daveshah1/nova/README.md

nova
====

This is the primary git repository for Team Nova's CanSat project, containing base station software, rover software, electronics and CAD data.
