daveshah1/nova/electronics/landing module/Landing Module.png

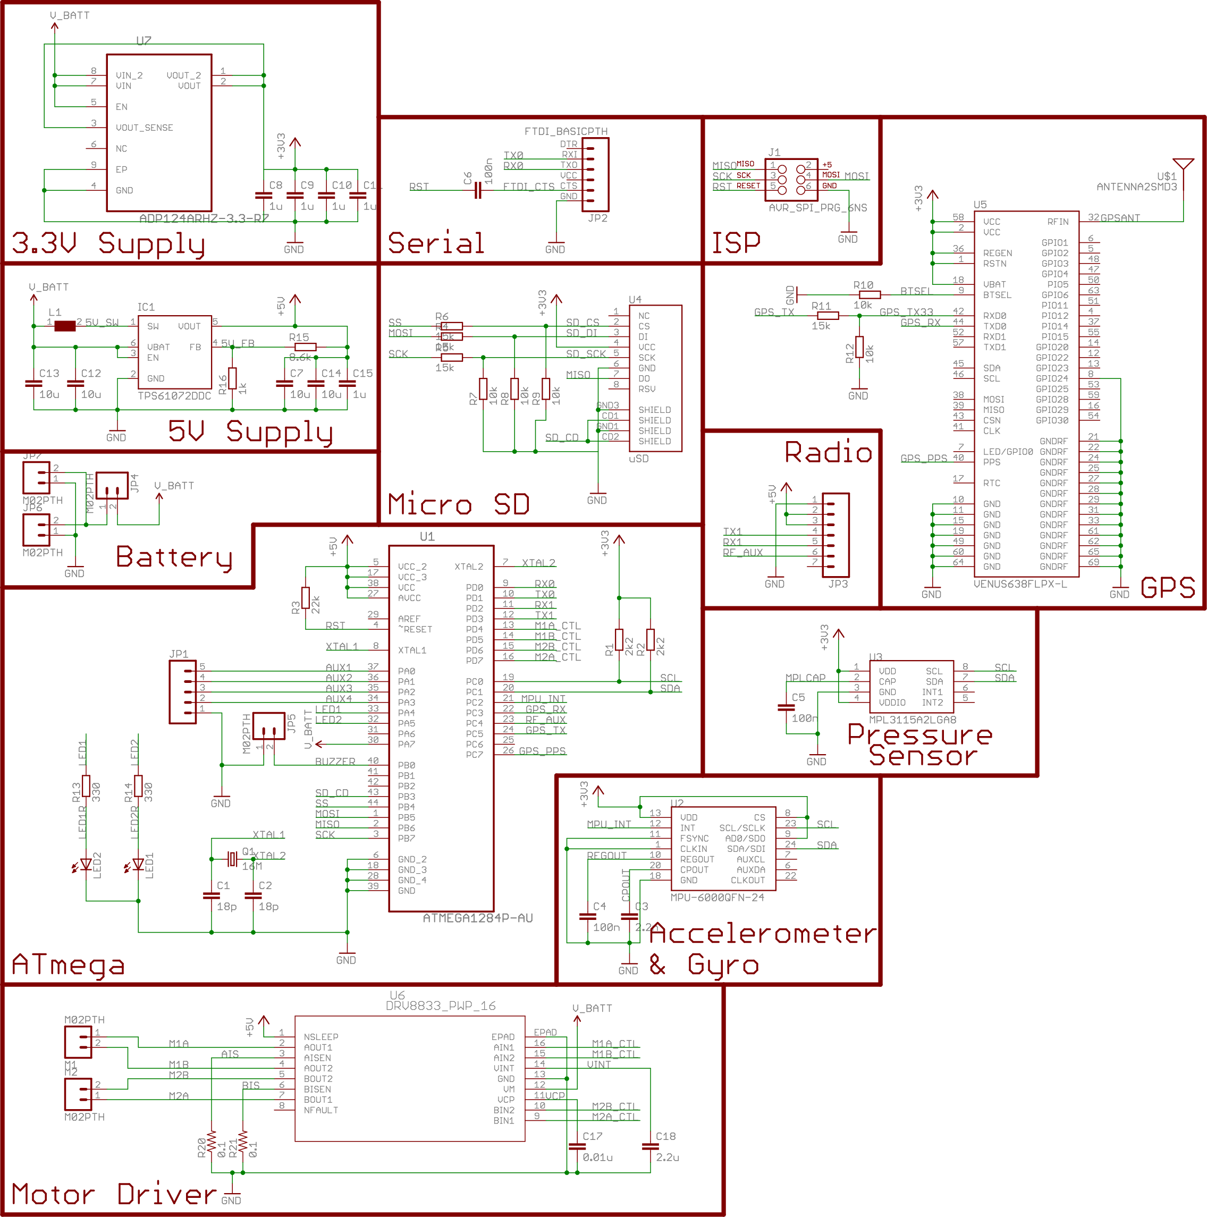
electronics/landing module/Landing Module.png
