daveshah1/nova/electronics/rover/CPU Board.png

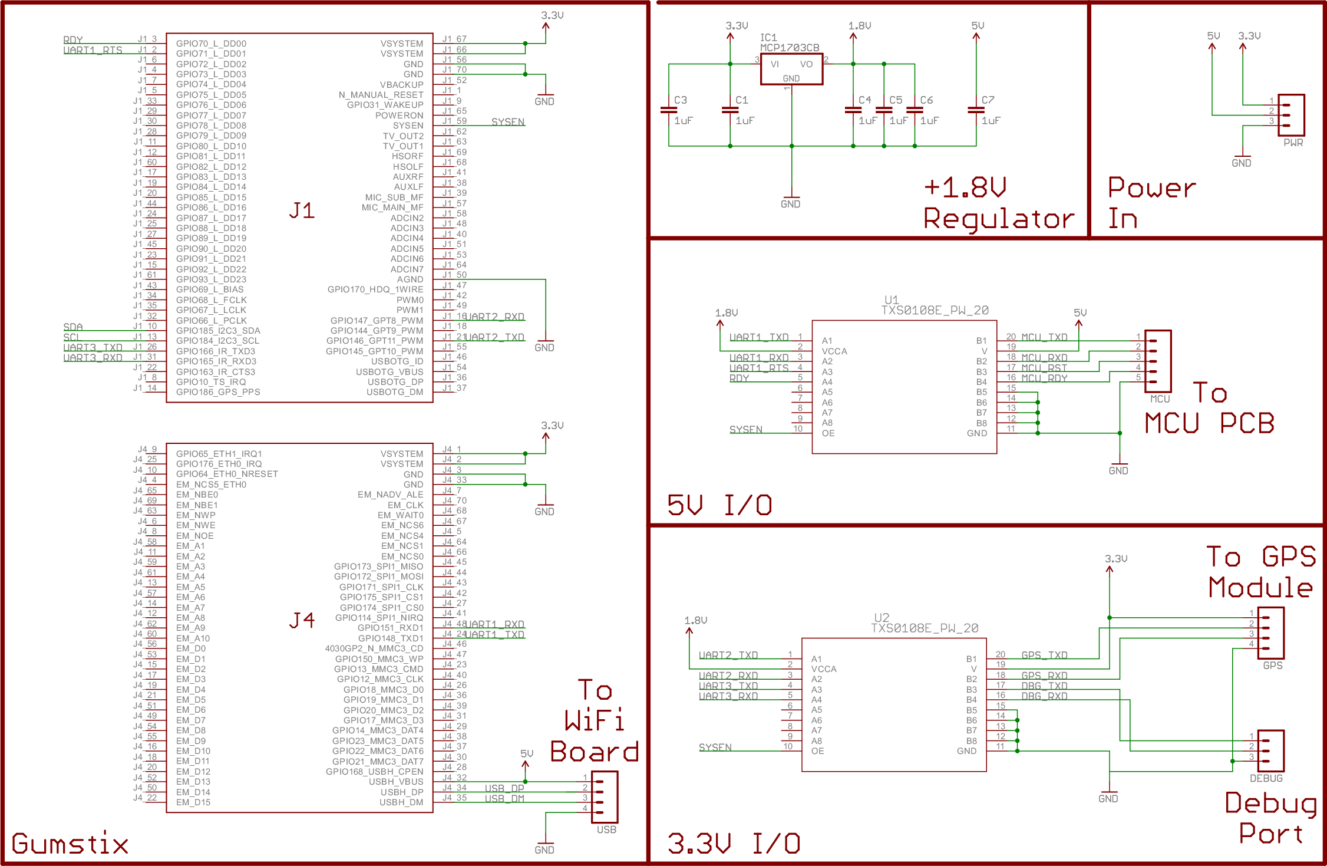
electronics/rover/CPU Board.png
