daveshah1/nova/electronics/rover/MCU Board.png

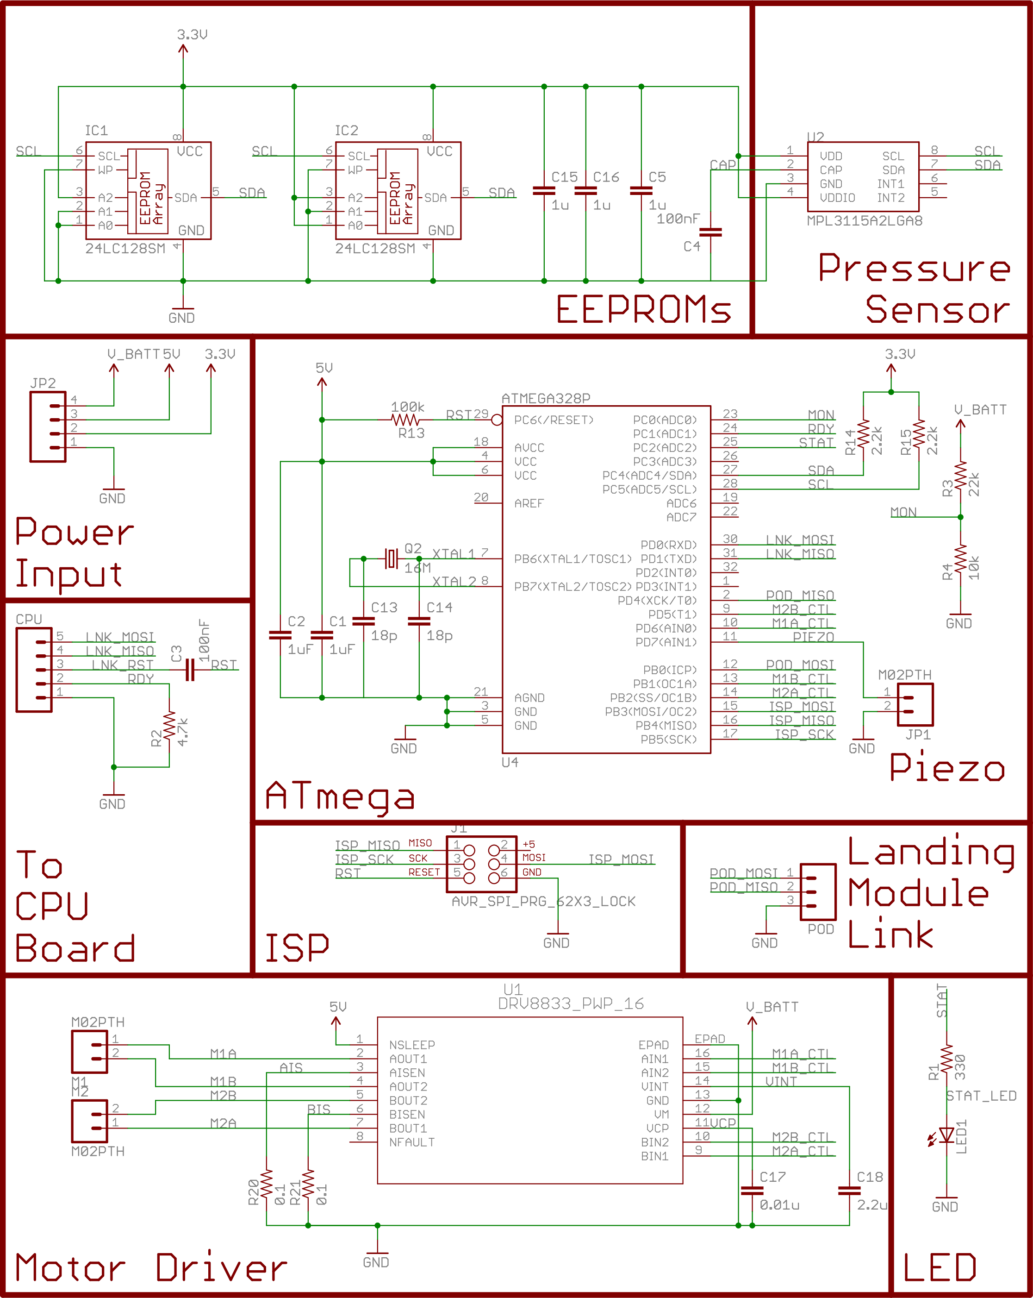
electronics/rover/MCU Board.png
