daveshah1/nova/electronics/rover/PMU Board.png

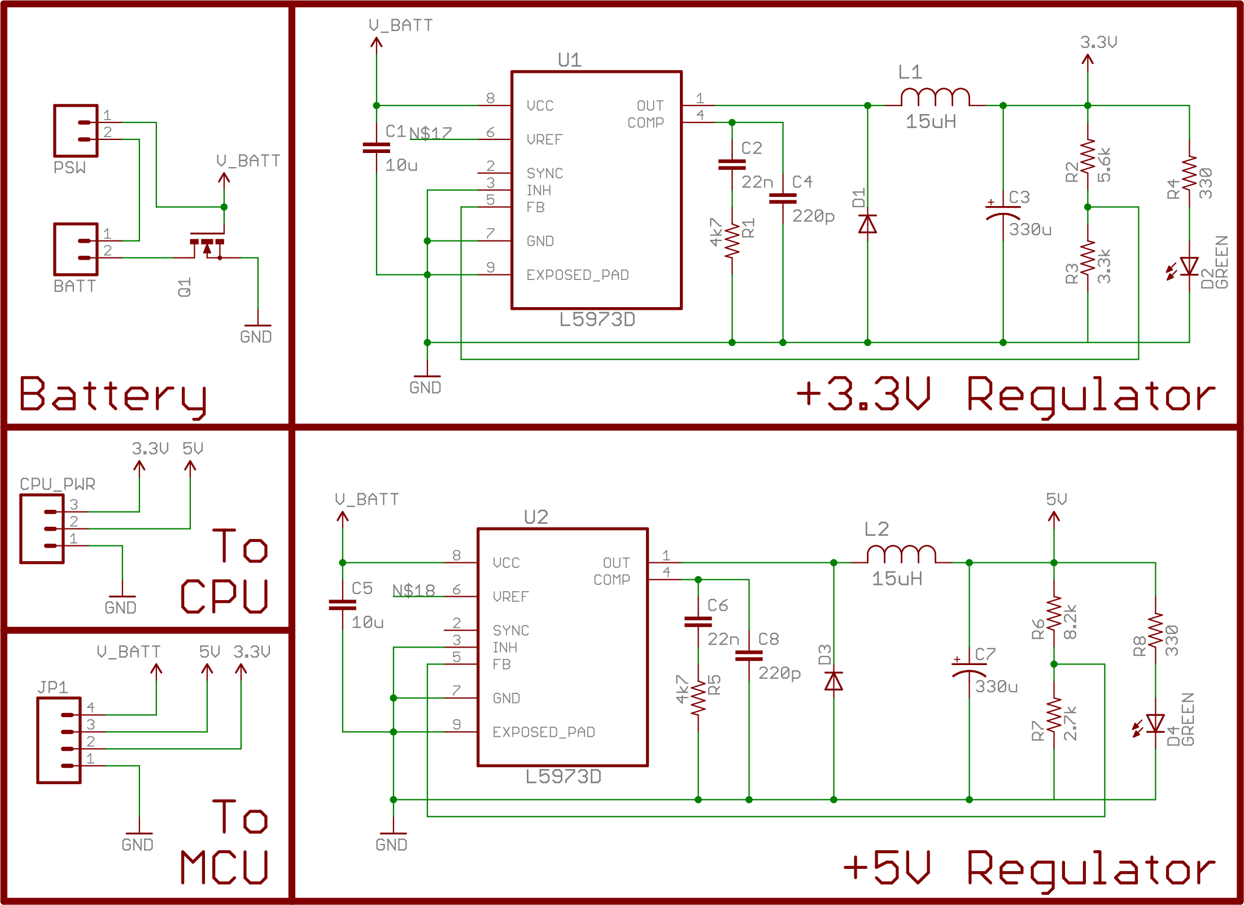
electronics/rover/PMU Board.png
