daveshah1/nova/houston/experimental/README

MAKE EACH OF THE FOLDERS HERE THE WORKSPACE FOLDER
TODO: Transfer all changes to master
