daveshah1/nova/electronics/landing module/Landing Module.pdf

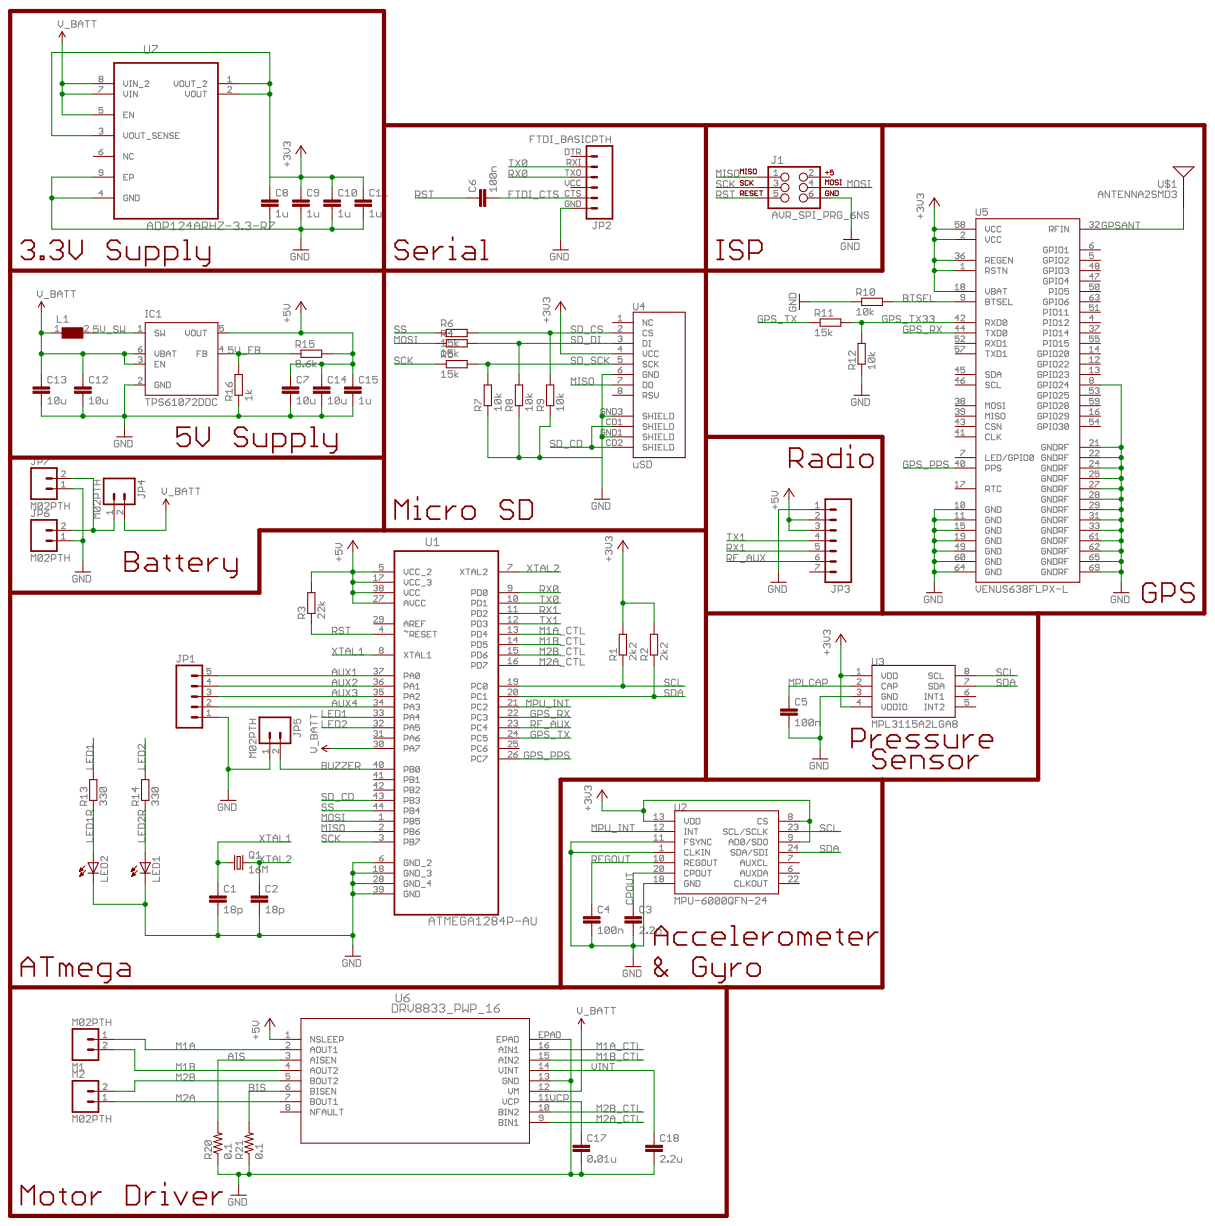
[picture p5: page 1]
