daveshah1/nova/electronics/rover/CPU Board.pdf

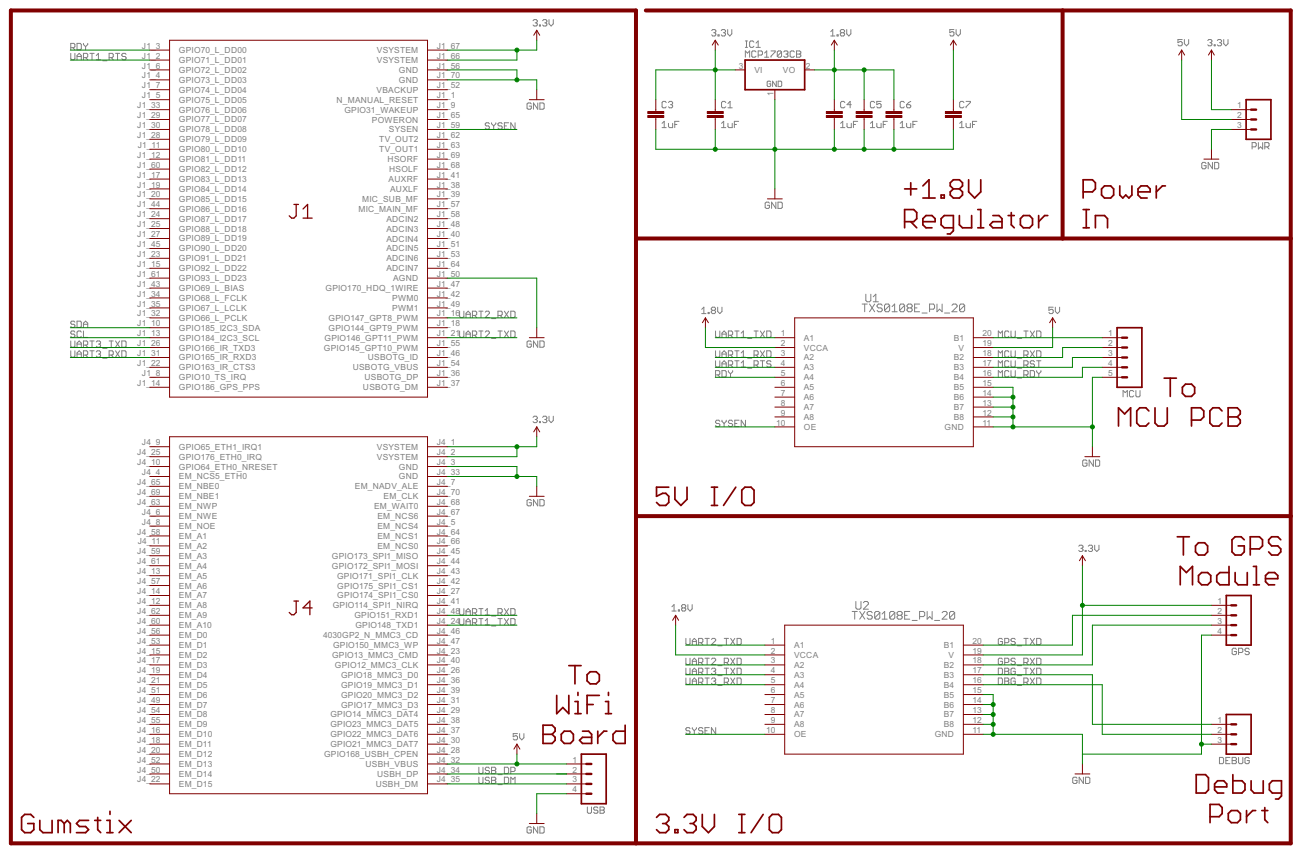
[picture p6: page 1]
