daveshah1/nova/electronics/rover/MCU Board.pdf

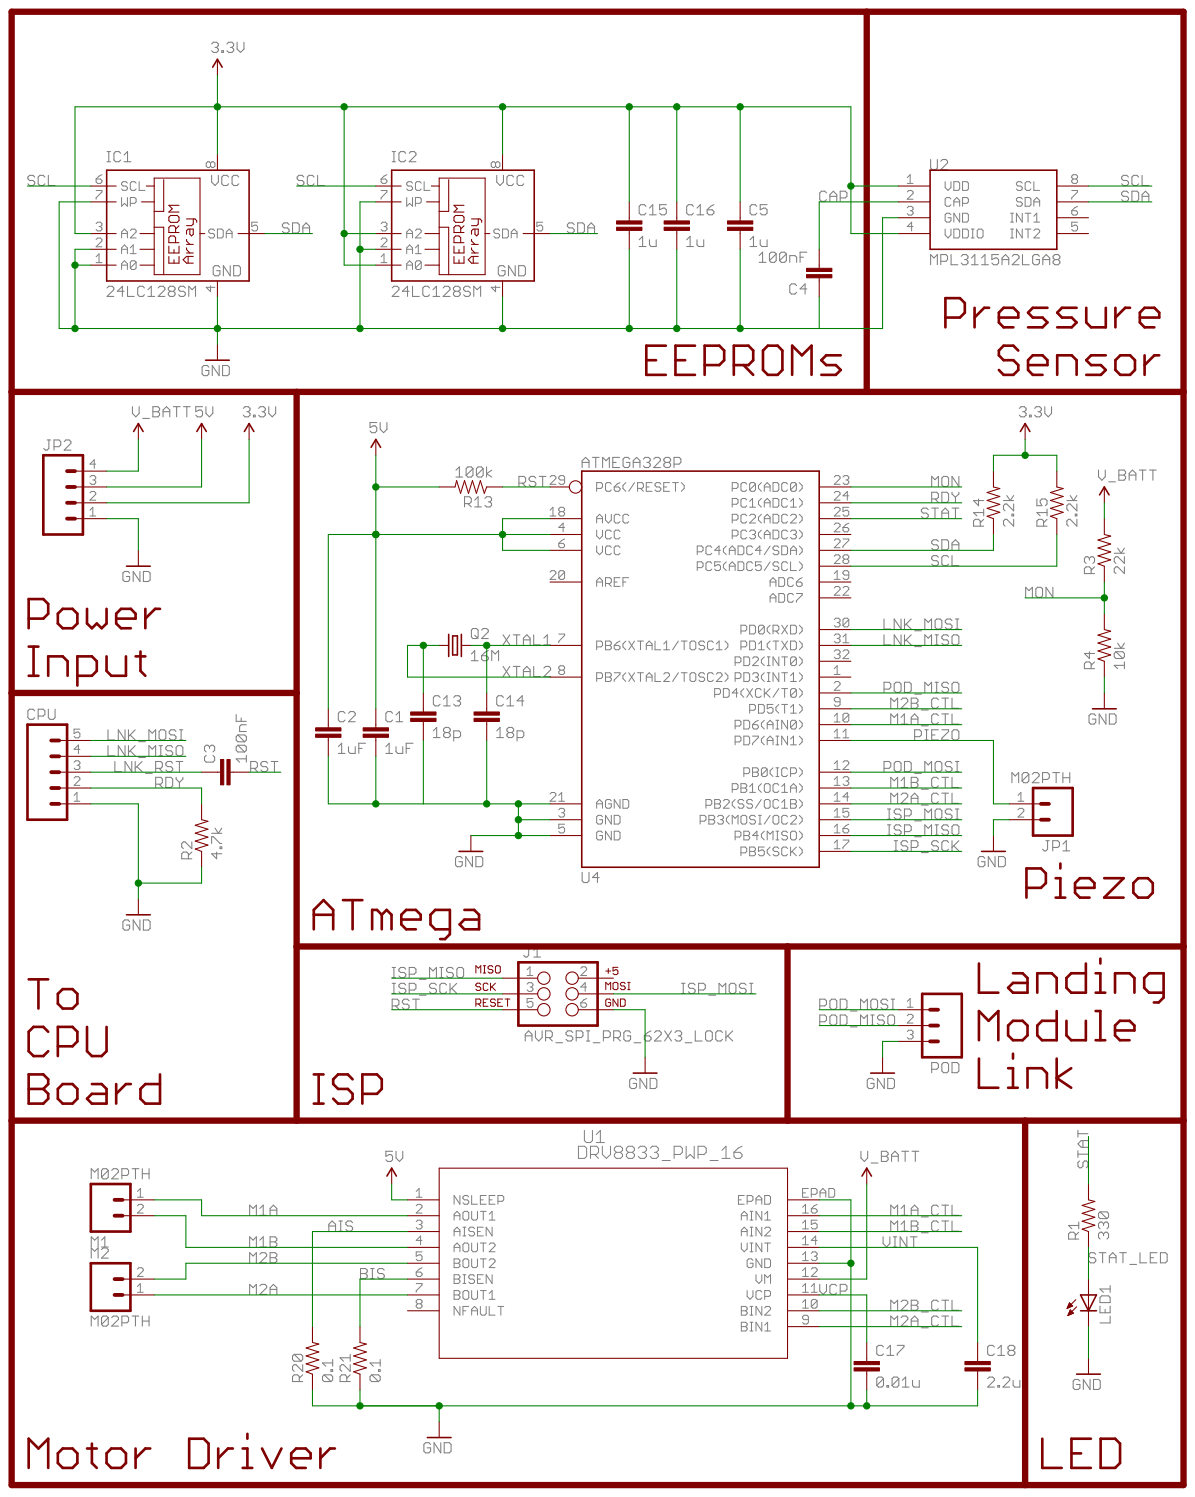
[picture p7: page 1]
