daveshah1/nova/electronics/rover/PMU Board.pdf

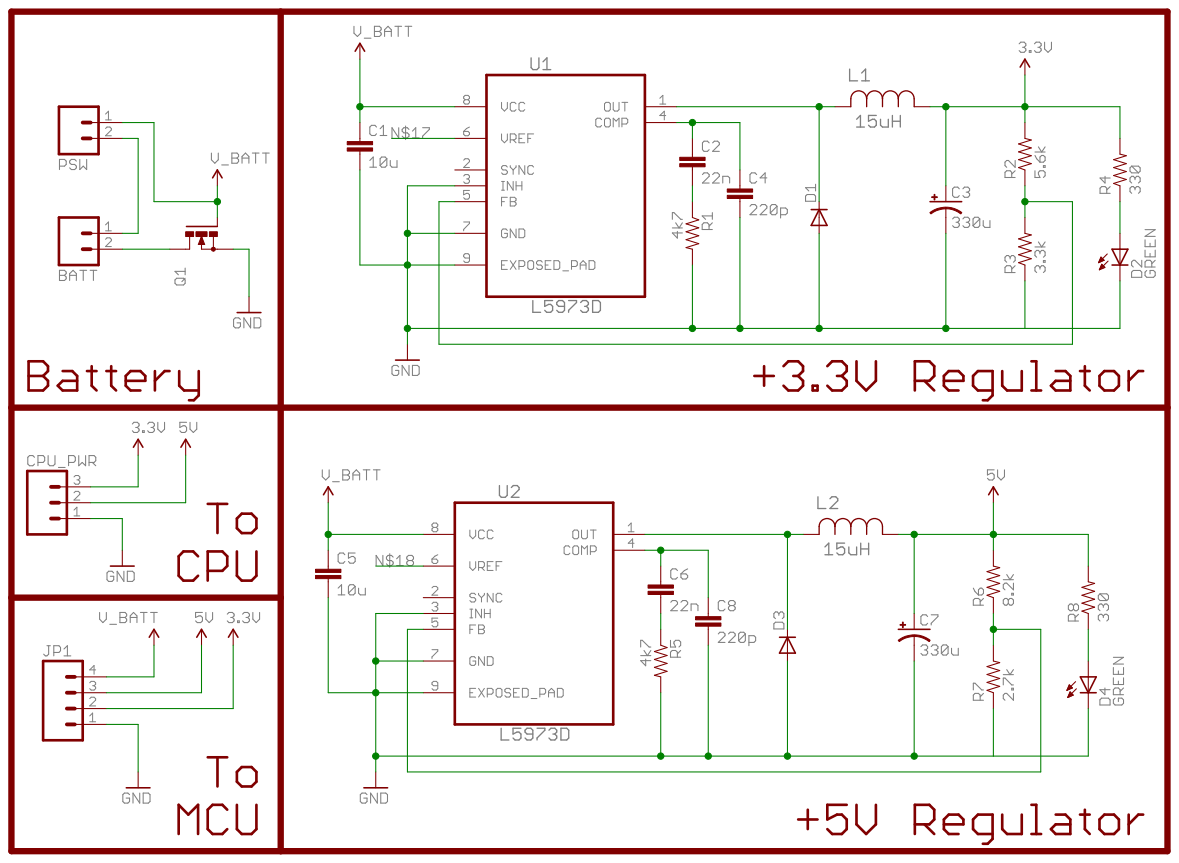
[picture p8: page 1]
