daveshah1/nova/electronics/rover/old (rev a)/MCU Board (Rev A).pdf

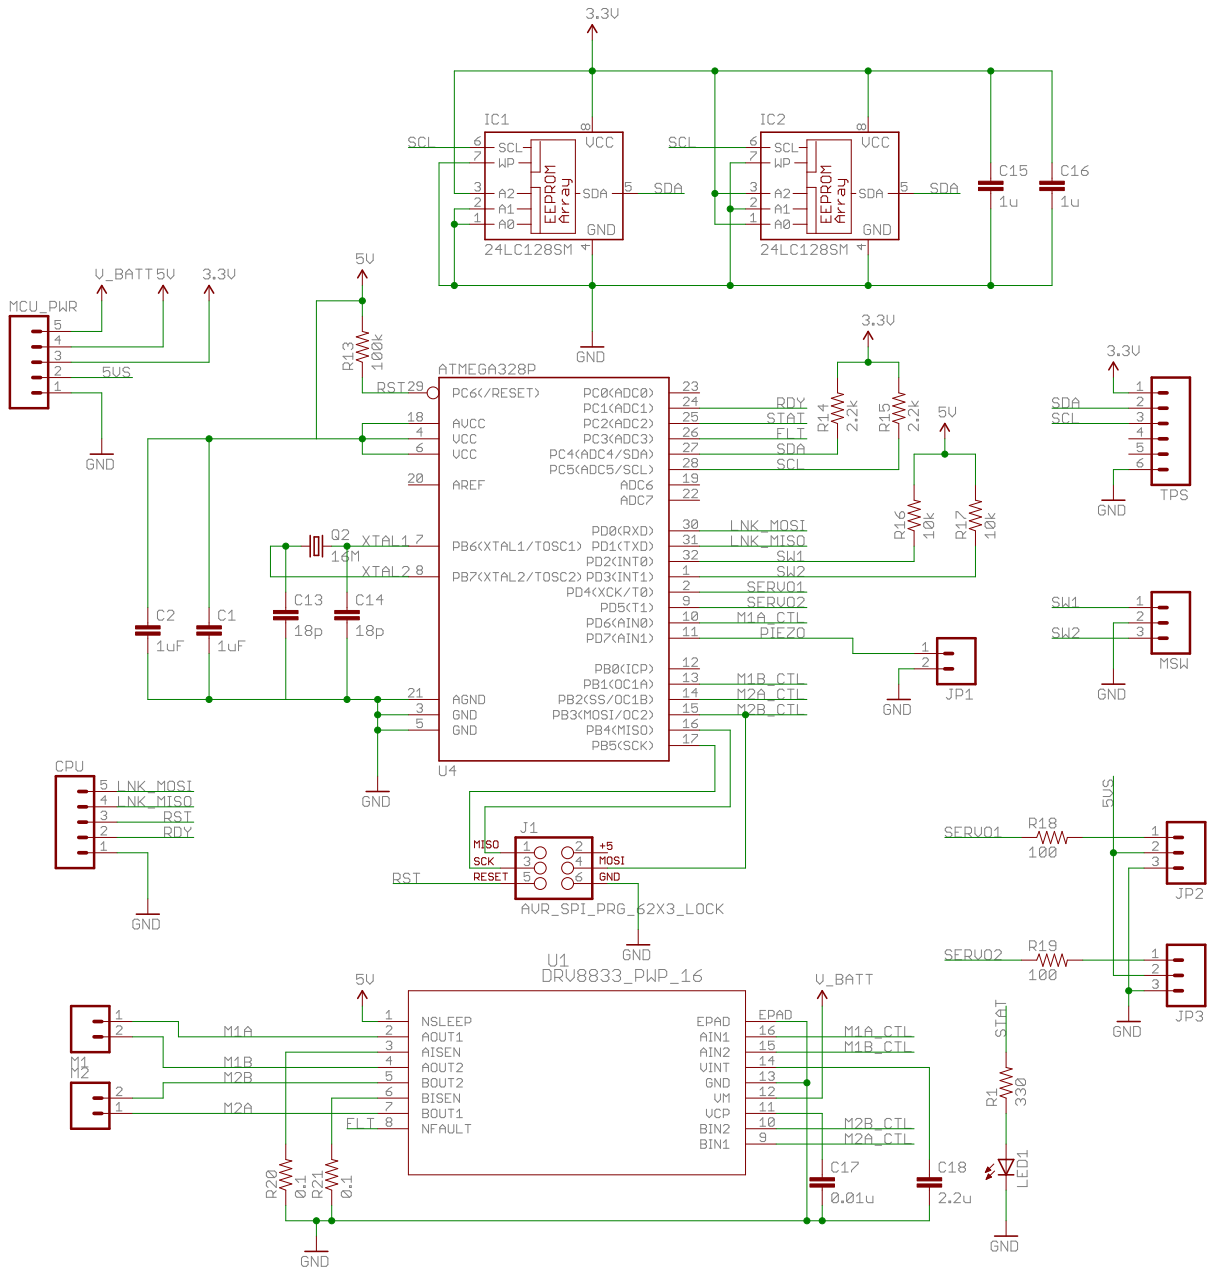
[picture p9: page 1]
