daveshah1/nova/electronics/rover/old (rev a)/PMU Board (Rev A).pdf

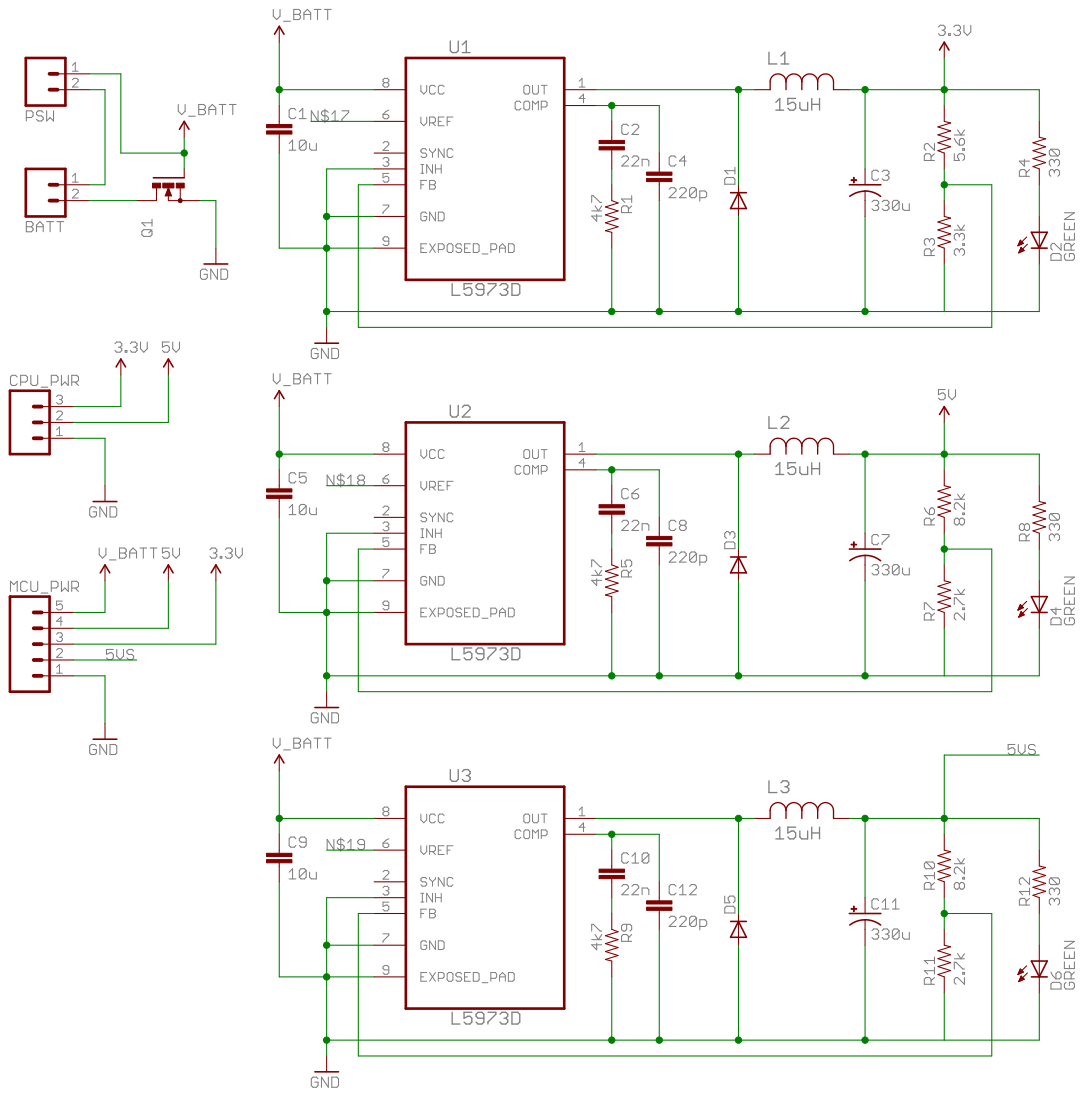
[picture p10: page 1]
