daveshah1/nova/electronics/rover/cpu.brd

## EAGLE design electronics/rover/cpu.brd (2013-09-23)

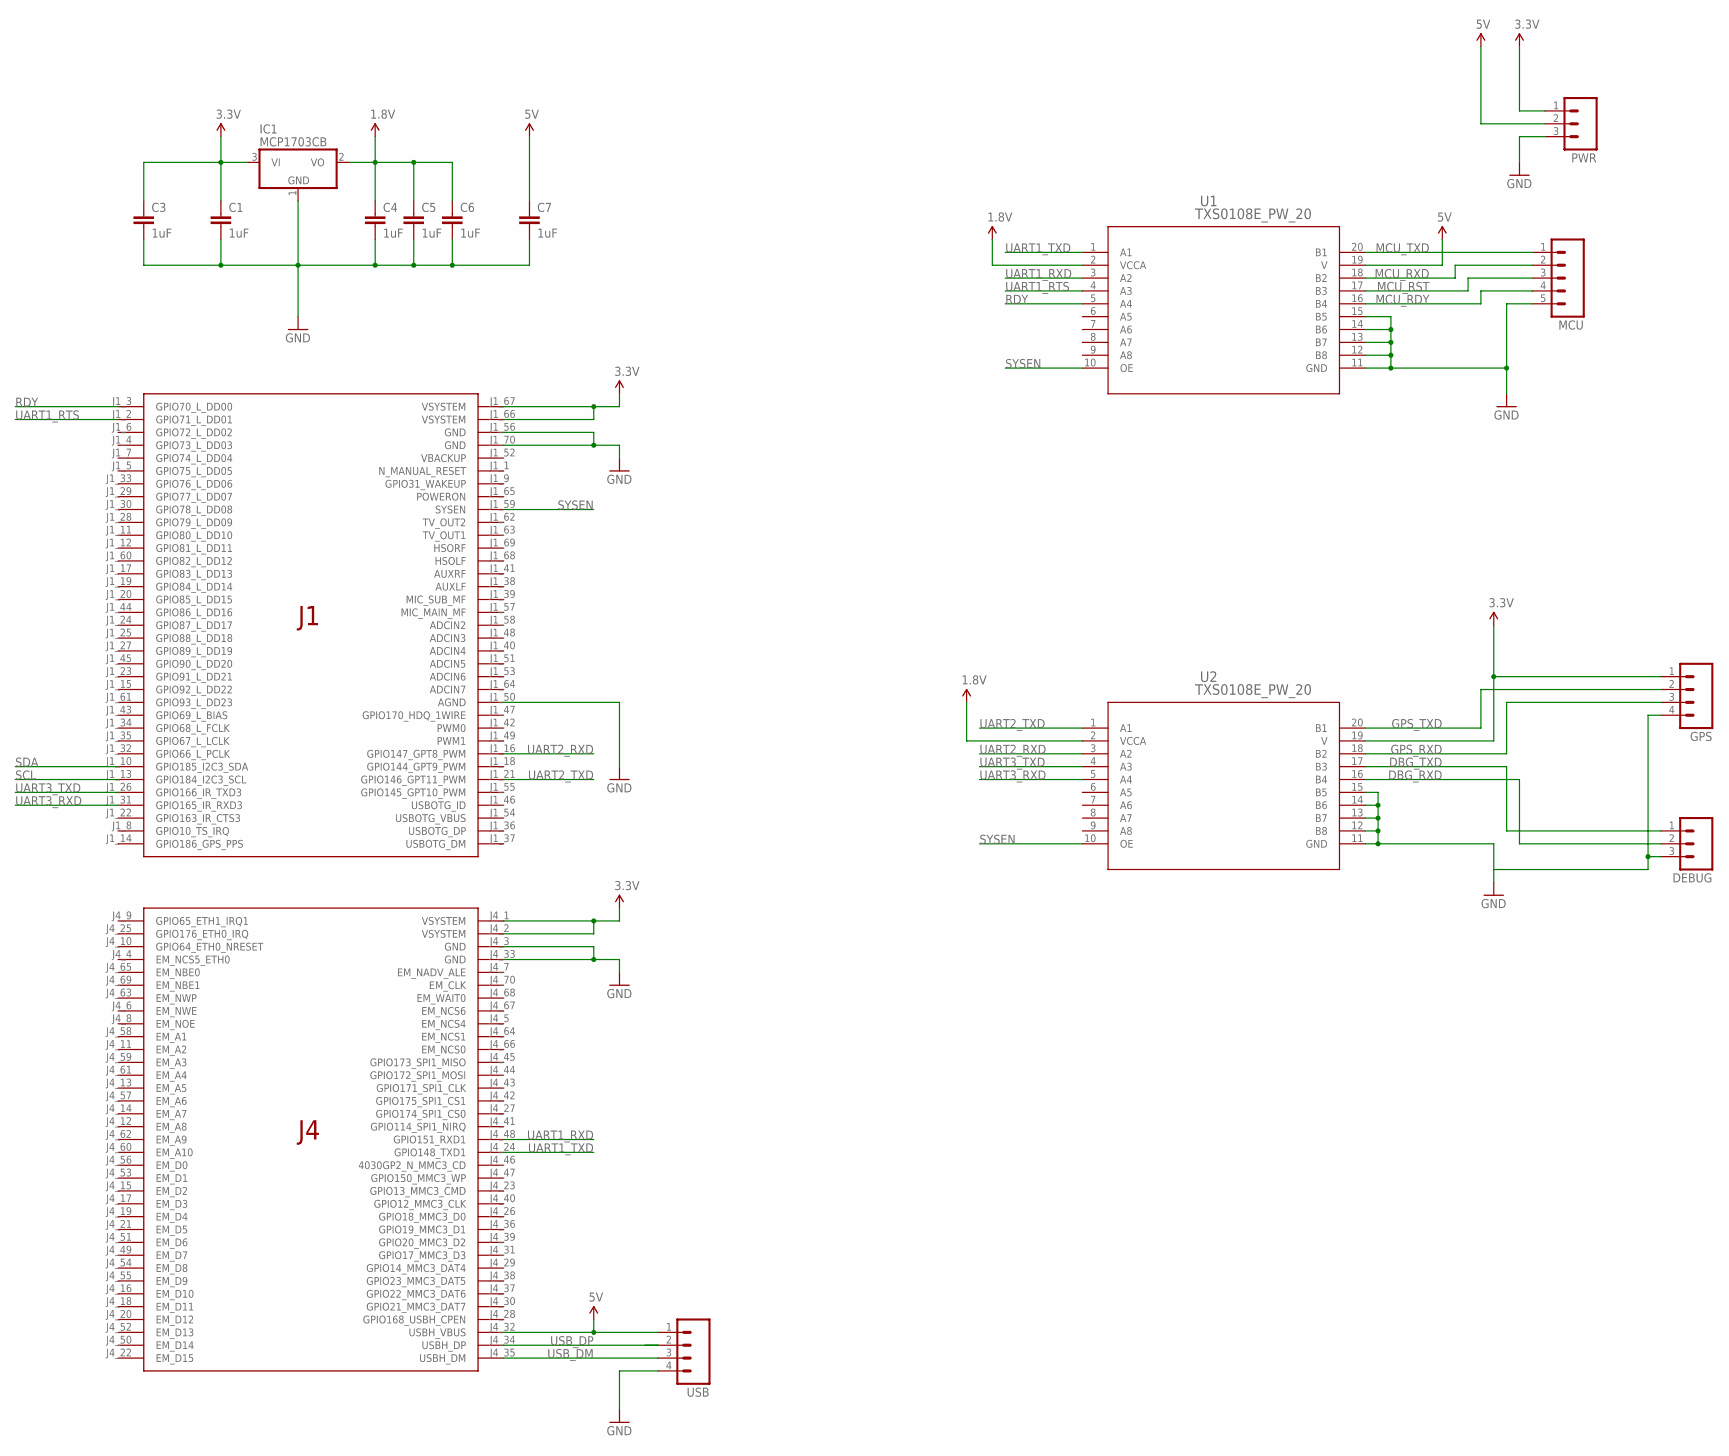
[picture p11: schematic cpu.sch]

Parts:
C1, C3, C4, C5, C6, C7: 1uF; 0805
DEBUG: M03LOCK_LONGPADS; 1X03_LOCK_LONGPADS
GPS: M04LONGPADS; 1X04_LONGPADS
IC1: MCP1703CB; SOT23
MCU: M05PTH_LONGPADS; 1X05_LONGPADS
PWR: M03LONGPADS; 1X03_LONGPADS
U1, U2: TXS0108E_PW_20; PW20
U$1: OVERO
USB: M04LONGPADS; 1X04_LONGPADS

Connections:
1.8V: C4.1, C5.1, C6.1, IC1.2 (VO), U1.2 (VCCA), U2.2 (VCCA)
3.3V: C1.1, C3.1, GPS.1, IC1.3 (VI), PWR.1, U2.19 (V), U$1.J1_66 (VSYSTEM), U$1.J1_67 (VSYSTEM), U$1.J4_1 (VSYSTEM), U$1.J4_2 (VSYSTEM)
5V: C7.1, PWR.2, U1.19 (V), U$1.J4_32 (USBH_VBUS), USB.1
DBG_RXD: DEBUG.2, U2.16 (B4)
DBG_TXD: DEBUG.1, U2.17 (B3)
GND: C1.2, C3.2, C4.2, C5.2, C6.2, C7.2, DEBUG.3, GPS.4, IC1.1 (GND), MCU.5, PWR.3, U1.11 (GND), U1.12 (B8), U1.13 (B7), U1.14 (B6), U1.15 (B5), U2.11 (GND), U2.12 (B8), U2.13 (B7), U2.14 (B6), U2.15 (B5), U$1.J1_50 (AGND), U$1.J1_56 (GND), U$1.J1_70 (GND), U$1.J4_3 (GND), U$1.J4_33 (GND), USB.4
GPS_RXD: GPS.3, U2.18 (B2)
GPS_TXD: GPS.2, U2.20 (B1)
MCU_RDY: MCU.4, U1.16 (B4)
MCU_RST: MCU.3, U1.17 (B3)
MCU_RXD: MCU.2, U1.18 (B2)
MCU_TXD: MCU.1, U1.20 (B1)
RDY: U1.5 (A4), U$1.J1_3 (GPIO70_L_DD00)
SCL: U$1.J1_13 (GPIO184_I2C3_SCL)
SDA: U$1.J1_10 (GPIO185_I2C3_SDA)
SYSEN: U1.10 (OE), U2.10 (OE), U$1.J1_59 (SYSEN)
UART1_RTS: U1.4 (A3), U$1.J1_2 (GPIO71_L_DD01)
UART1_RXD: U1.3 (A2), U$1.J4_48 (GPIO151_RXD1)
UART1_TXD: U1.1 (A1), U$1.J4_24 (GPIO148_TXD1)
UART2_RXD: U2.3 (A2), U$1.J1_16 (GPIO147_GPT8_PWM)
UART2_TXD: U2.1 (A1), U$1.J1_21 (GPIO146_GPT11_PWM)
UART3_RXD: U2.5 (A4), U$1.J1_31 (GPIO165_IR_RXD3)
UART3_TXD: U2.4 (A3), U$1.J1_26 (GPIO166_IR_TXD3)
USB_DM: U$1.J4_35 (USBH_DM), USB.3
USB_DP: U$1.J4_34 (USBH_DP), USB.2

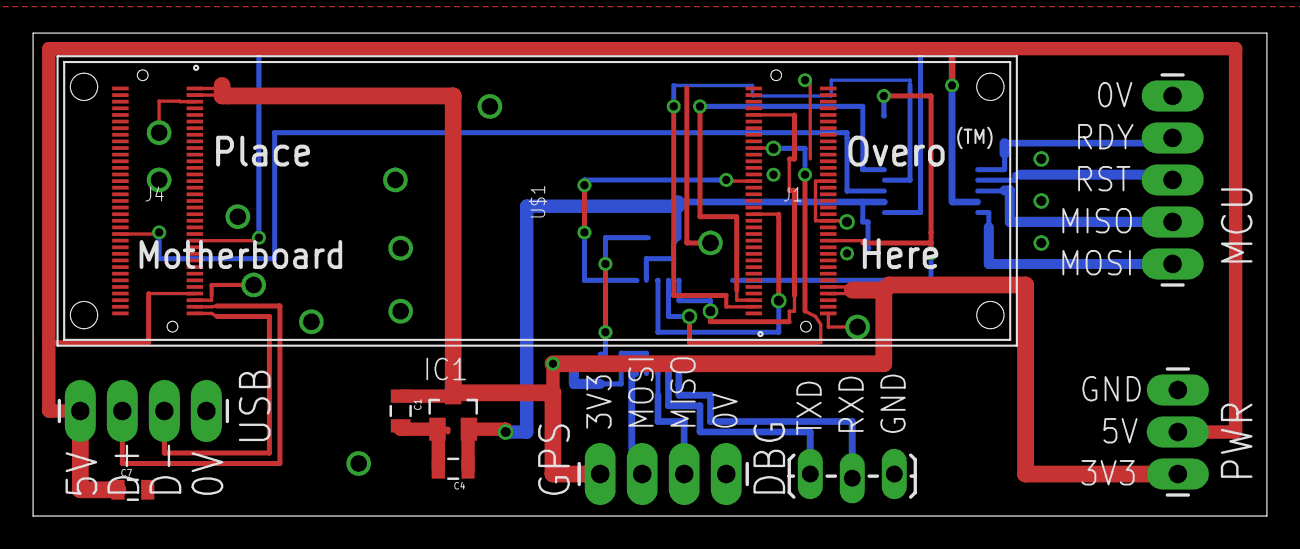
[picture p12: board cpu.brd from above]

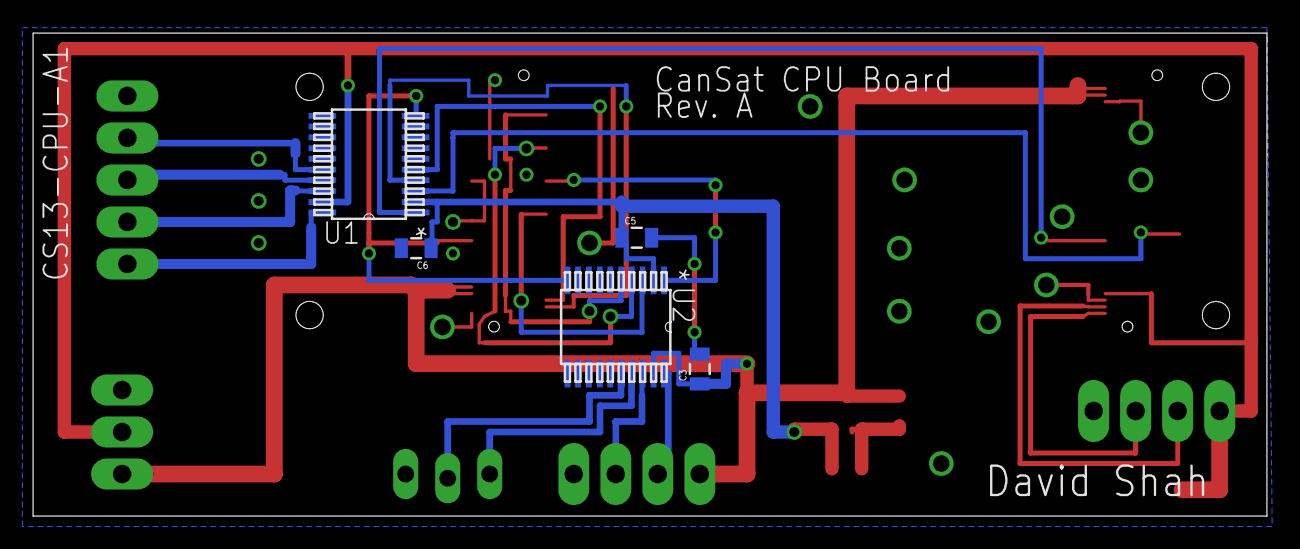
[picture p13: board cpu.brd from below]

Board: 2 copper layers, 74.6 x 29.2 mm, 15 parts (5 on the bottom side), 23 nets.
