daveshah1/nova/electronics/landing module/module.brd

## EAGLE design electronics/landing module/module.brd (2013-11-29)

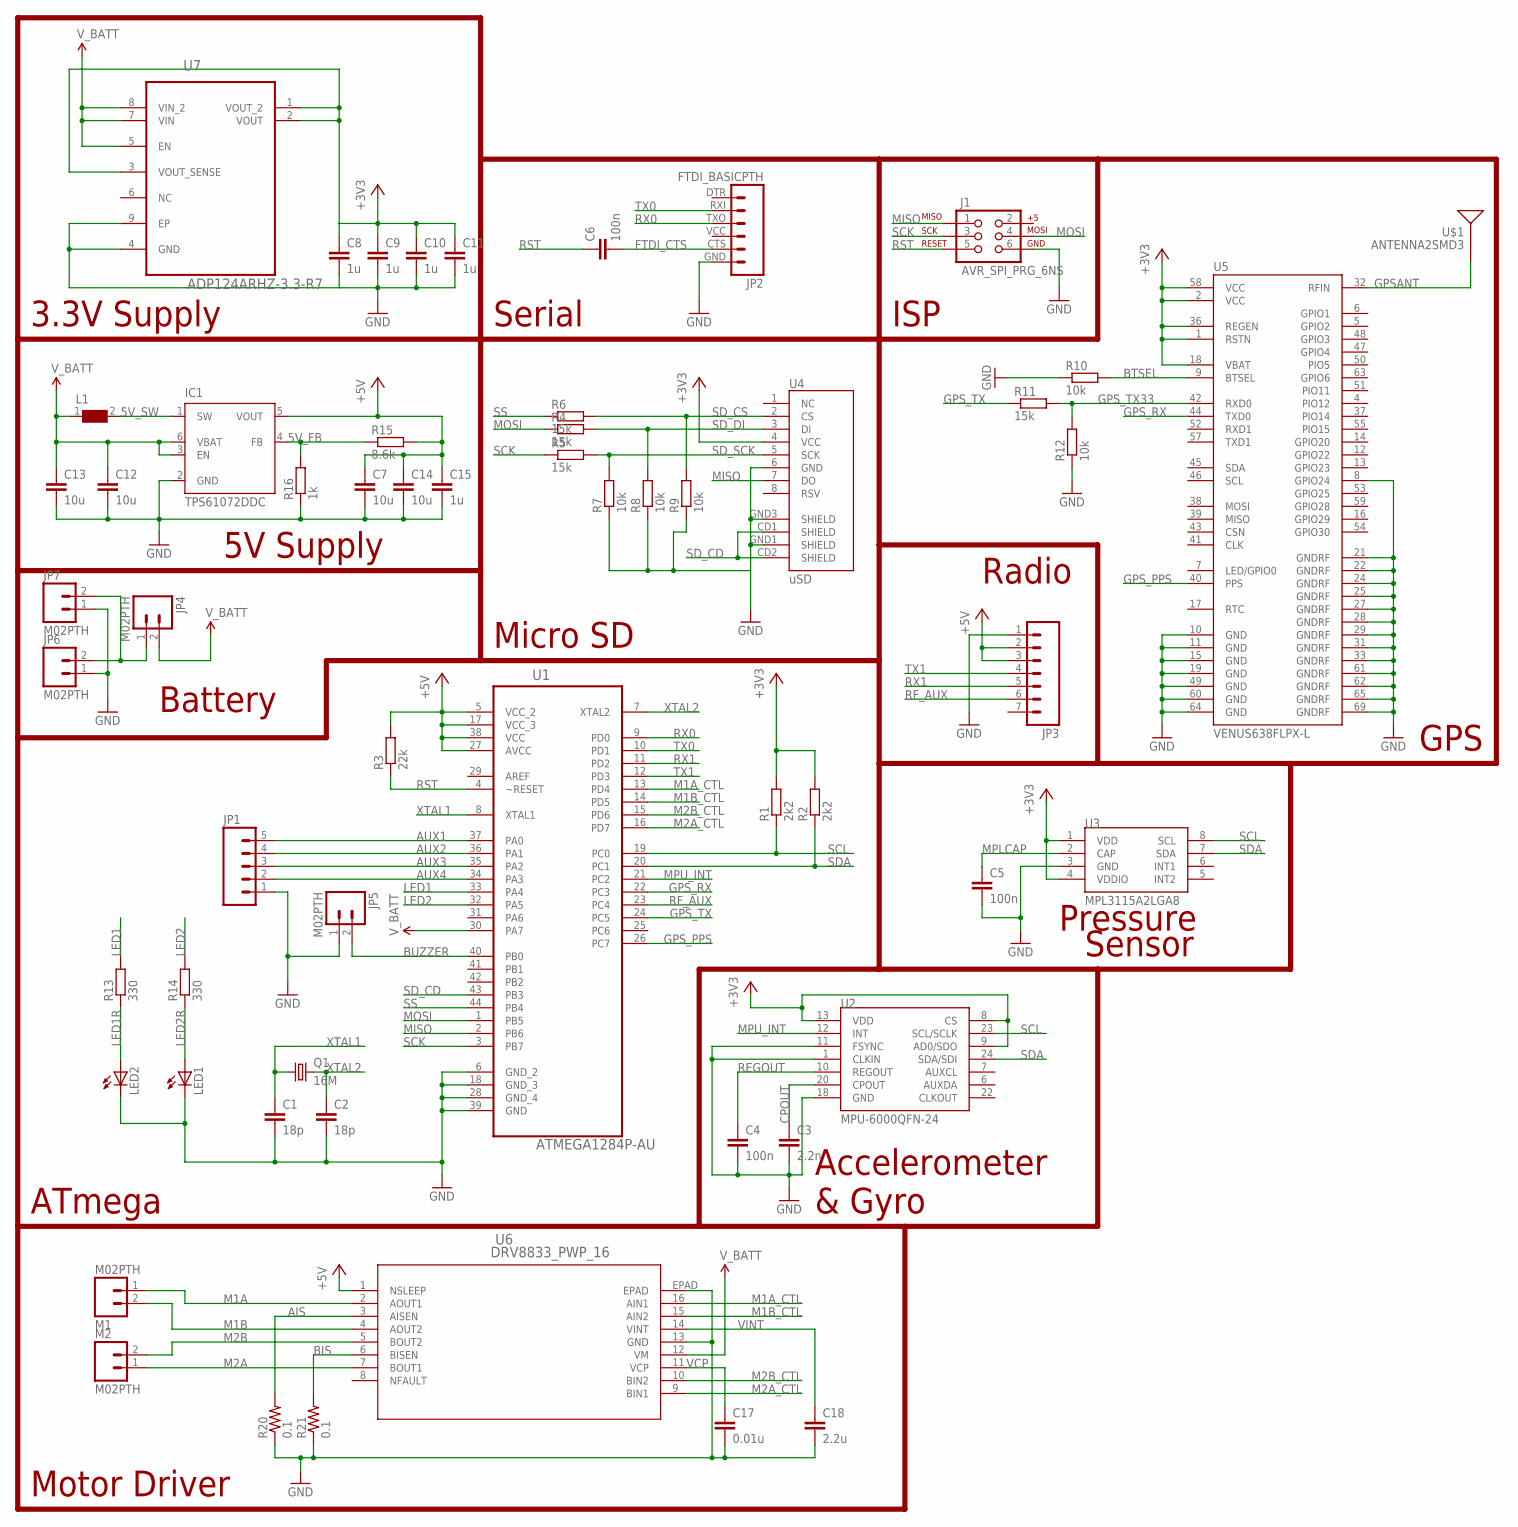
[picture p14: schematic module.sch]

Parts:
C1, C2: 18p; C0805
C3: 2.2n; C0805
C4, C5, C6: 100n; C0805
C7, C12, C13, C14: 10u; C0805
C8, C9, C10, C11: 1u; C0603
C15: 1u; C0805
C17: 0.01u; 0805
C18: 2.2u; 0805
IC1: TPS61072DDC; TSOT23-6_DDC
J1: AVR_SPI_PRG_6NS; 2X3-NS
JP1: M05PTH; 1X05
JP2: FTDI_BASICPTH; FTDI_BASIC
JP3: M07; 1X07
JP4, JP5, JP6, JP7: M02PTH; 1X02
L1: WE-TPC-744031004_3816; WE-TPC_3816
LED1, LED2: LEDCHIPLED_0805; CHIPLED_0805
M1, M2: M02PTH; 1X02
Q1: 16M; HC49UP
R1, R2: 2k2; R0805
R3: 22k; R0805
R4, R5, R6, R11: 15k; R0805
R7, R8, R9, R10, R12: 10k; R0805
R13, R14: 330; R0805
R15: 8.6k; R0805
R16: 1k; R0805
R20, R21: 0.1; 1206
U1: ATMEGA1284P-AU; QFP80P1200X1200X120-44N
U2: MPU-6000QFN-24; QFN-24-TESTING
U3: MPL3115A2LGA8; LGA8
U4: uSD; MICRO-SD-SOCKET-PP
U5: VENUS638FLPX-L; VENUS638FLPX
U6: DRV8833_PWP_16; PWP16_2P31X2P46
U7: ADP124ARHZ-3.3-R7; SOP65P490X110-9N
U$1: ANTENNA2SMD3; ANTENNA-CHIP4

Connections:
5V_FB: IC1.4 (FB), R15.1, R16.2
5V_SW: IC1.1 (SW), L1.2
+3V3: C8.1, C9.1, C10.1, C11.1, R1.2, R2.2, U2.8 (CS), U2.9 (AD0/SDO), U2.13 (VDD), U3.1 (VDD), U3.4 (VDDIO), U4.4 (VCC), U5.1 (RSTN), U5.2 (VCC), U5.18 (VBAT), U5.36 (REGEN), U5.58 (VCC), U7.1 (VOUT_2), U7.2 (VOUT), U7.3 (VOUT_SENSE)
+5V: C7.1, C14.1, C15.1, IC1.5 (VOUT), JP3.2, JP3.3, R3.2, R15.2, U1.5 (VCC_2), U1.17 (VCC_3), U1.27 (AVCC), U1.38 (VCC), U6.1 (NSLEEP)
AIS: R20.2, U6.3 (AISEN)
AUX1: JP1.5, U1.37 (PA0)
AUX2: JP1.4, U1.36 (PA1)
AUX3: JP1.3, U1.35 (PA2)
AUX4: JP1.2, U1.34 (PA3)
BIS: R21.2, U6.6 (BISEN)
BTSEL: R10.2, U5.9 (BTSEL)
BUZZER: JP5.2, U1.40 (PB0)
CPOUT: C3.1, U2.20 (CPOUT)
FTDI_CTS: C6.2, JP2.CTS (5)
GND: C1.2, C2.2, C3.2, C4.2, C5.2, C7.2, C8.2, C9.2, C10.2, C11.2, C12.2, C13.2, C14.2, C15.2, C17.2, C18.2, IC1.2 (GND), J1.6, JP1.1, JP2.GND (6), JP3.1, JP5.1, JP6.1, JP7.1, LED1.C, LED2.C, R7.1, R8.1, R9.1, R10.1, R12.1, R16.1, R20.1, R21.1, U1.6 (GND_2), U1.18 (GND_3), U1.28 (GND_4), U1.39 (GND), U2.1 (CLKIN), U2.11 (FSYNC), U2.18 (GND), U3.3 (GND), U4.6 (GND), U4.GND1 (SHIELD), U4.GND3 (SHIELD), U5.8 (GPIO24), U5.10 (GND), U5.11 (GND), U5.15 (GND), U5.19 (GND), U5.21 (GNDRF), U5.22 (GNDRF), U5.24 (GNDRF), U5.25 (GNDRF), U5.27 (GNDRF), U5.28 (GNDRF), U5.29 (GNDRF), U5.31 (GNDRF), U5.33 (GNDRF), U5.49 (GND), U5.60 (GND), U5.61 (GNDRF), U5.62 (GNDRF), U5.64 (GND), U5.65 (GNDRF), U5.69 (GNDRF), U6.13 (GND), U6.EPAD, U7.4 (GND), U7.9 (EP)
GPSANT: U5.32 (RFIN), U$1.SIG
GPS_PPS: U1.26 (PC7), U5.40 (PPS)
GPS_RX: U1.22 (PC3), U5.44 (TXD0)
GPS_TX: R11.1, U1.24 (PC5)
GPS_TX33: R11.2, R12.2, U5.42 (RXD0)
LED1: R13.2, U1.33 (PA4)
LED1R: LED2.A, R13.1
LED2: R14.2, U1.32 (PA5)
LED2R: LED1.A, R14.1
M1A: M1.1, U6.2 (AOUT1)
M1A_CTL: U1.13 (PD4), U6.16 (AIN1)
M1B: M1.2, U6.4 (AOUT2)
M1B_CTL: U1.14 (PD5), U6.15 (AIN2)
M2A: M2.1, U6.7 (BOUT1)
M2A_CTL: U1.16 (PD7), U6.9 (BIN1)
M2B: M2.2, U6.5 (BOUT2)
M2B_CTL: U1.15 (PD6), U6.10 (BIN2)
MISO: J1.1, U1.2 (PB6), U4.7 (DO)
MOSI: J1.4, R4.1, U1.1 (PB5)
MPLCAP: C5.1, U3.2 (CAP)
MPU_INT: U1.21 (PC2), U2.12 (INT)
unnamed: JP4.1, JP6.2, JP7.2
REGOUT: C4.1, U2.10 (REGOUT)
RF_AUX: JP3.6, U1.23 (PC4)
RST: C6.1, J1.5, R3.1, U1.4 (~RESET)
RX0: JP2.TXO (3), U1.9 (PD0)
RX1: JP3.5, U1.11 (PD2)
SCK: J1.3, R5.1, U1.3 (PB7)
SCL: R1.1, U1.19 (PC0), U2.23 (SCL/SCLK), U3.8 (SCL)
SDA: R2.1, U1.20 (PC1), U2.24 (SDA/SDI), U3.7 (SDA)
SD_CD: U1.43 (PB3), U4.CD1 (SHIELD), U4.CD2 (SHIELD)
SD_CS: R6.2, R9.2, U4.2 (CS)
SD_DI: R4.2, R8.2, U4.3 (DI)
SD_SCK: R5.2, R7.2, U4.5 (SCK)
SS: R6.1, U1.44 (PB4)
TX0: JP2.RXI (2), U1.10 (PD1)
TX1: JP3.4, U1.12 (PD3)
VCP: C17.1, U6.11 (VCP)
VINT: C18.1, U6.14 (VINT)
V_BATT: C12.1, C13.1, IC1.3 (EN), IC1.6 (VBAT), JP4.2, L1.1, U1.30 (PA7), U6.12 (VM), U7.5 (EN), U7.7 (VIN), U7.8 (VIN_2)
XTAL1: C1.1, Q1.1, U1.8 (XTAL1)
XTAL2: C2.1, Q1.2, U1.7 (XTAL2)

Notes on the sheet:
Motor Driver
ATmega
Pressure
Sensor
GPS
Radio
Micro SD
Battery
5V Supply
3.3V Supply
Serial
ISP
Accelerometer & Gyro

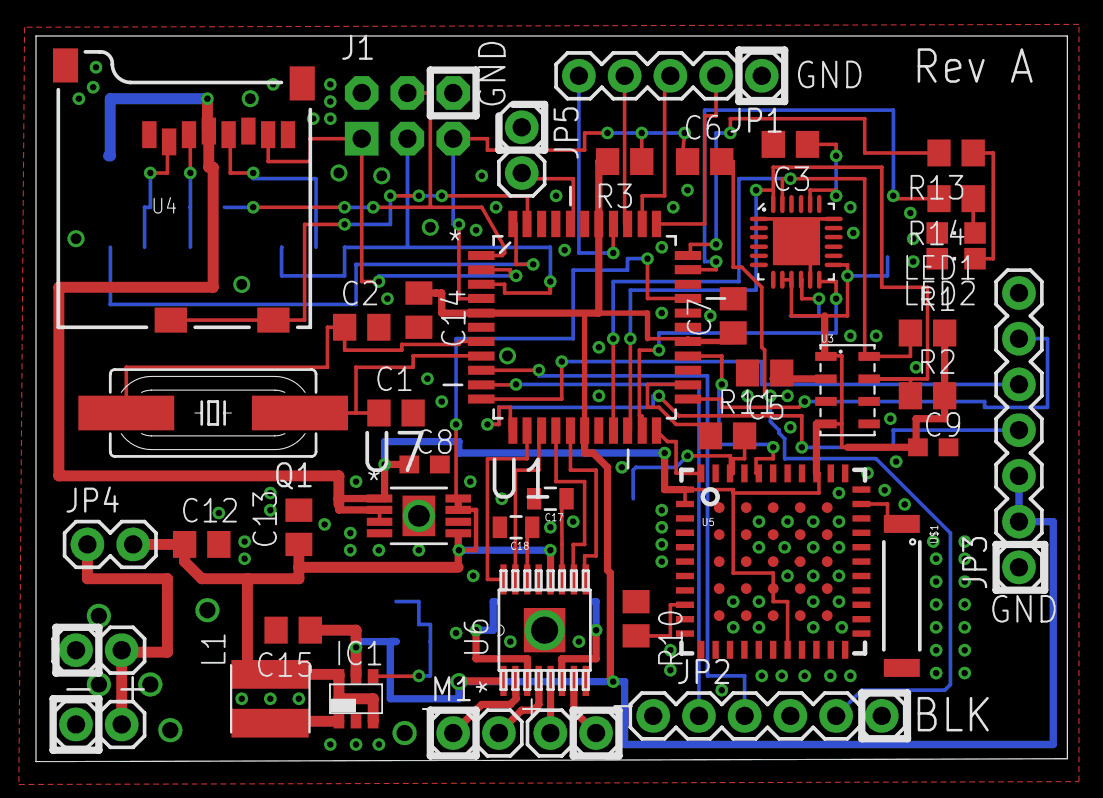
[picture p15: board module.brd from above]

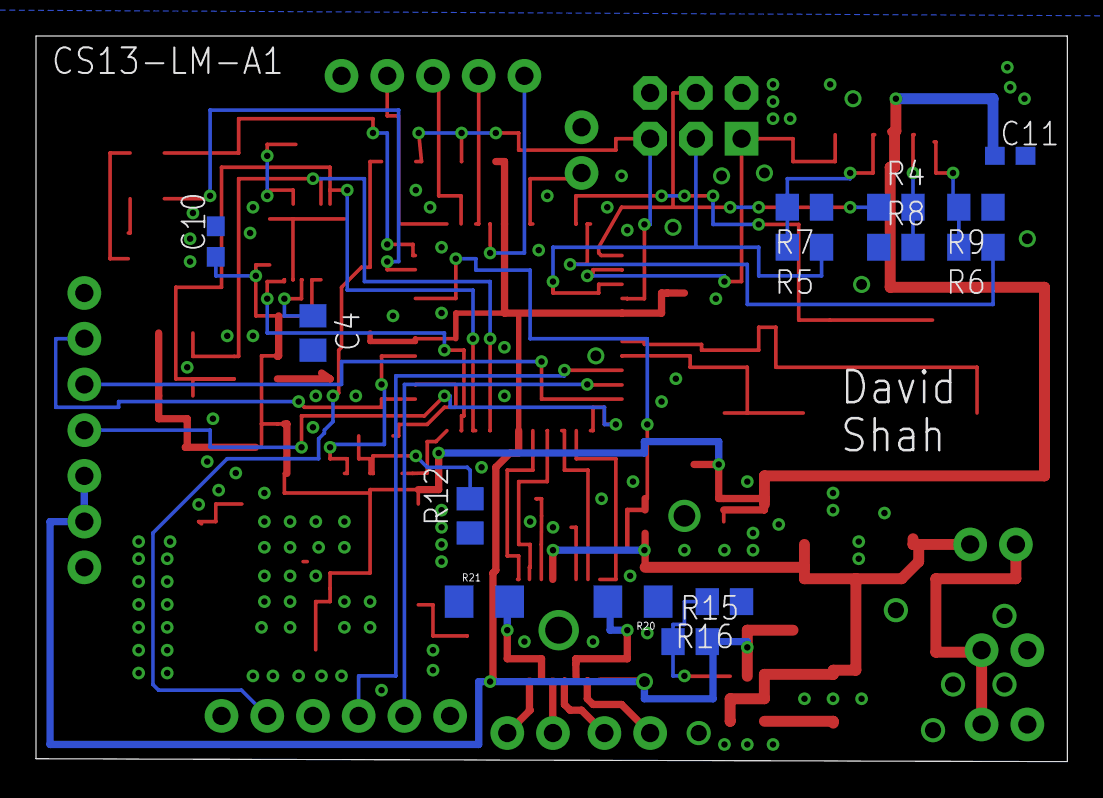
[picture p16: board module.brd from below]

Board: 2 copper layers, 57.3 x 40.3 mm, 58 parts (14 on the bottom side), 57 nets.
