daveshah1/nova/electronics/rover/pmu.brd

## EAGLE design electronics/rover/pmu.brd (2013-11-29)

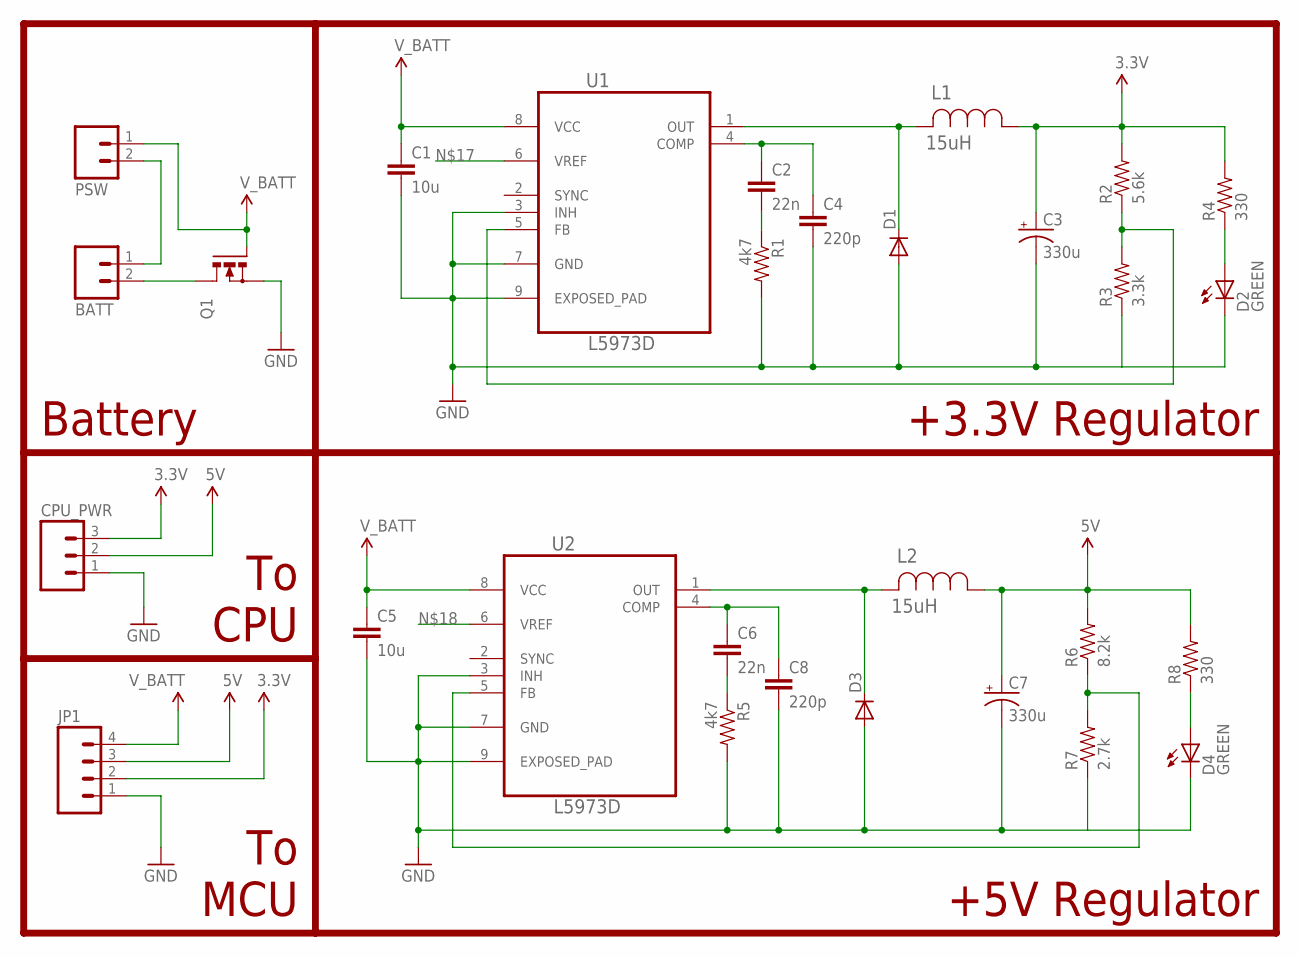
[picture p17: schematic pmu.sch]

Parts:
BATT: M02PTH; 1X02
C1, C5: 10u; 1210
C2, C6: 22n; 0805
C3, C7: 330u; EIA7343
C4, C8: 220p; 0805
CPU_PWR: M03PTH; 1X03
D1, D3: DIODESMB; SMB-DIODE
D2, D4: GREEN; CHIP-LED0805
JP1: M04PTH; 1X04
L1, L2: 15uH; IND_ELL8TP
PSW: M02PTH; 1X02
Q1: N-MOSFET-SO8S; SO-08
R1, R5: 4k7; 0805
R2: 5.6k; 0805
R3: 3.3k; 0805
R4, R8: 330; 0805
R6: 8.2k; 0805
R7: 2.7k; 0805
U1, U2: L5973D; SOP127P600X170-9N

Connections:
3.3V: C3.A (+), CPU_PWR.3, JP1.2, L1.1, R2.2, R4.2
5V: C7.A (+), CPU_PWR.2, JP1.3, L2.1, R6.2, R8.2
GND: C1.2, C3.C (-), C4.2, C5.2, C7.C (-), C8.2, CPU_PWR.1, D1.A, D2.C, D3.A, D4.C, JP1.1, Q1.1 (S), Q1.2 (S), Q1.3 (S), R1.2, R3.1, R5.2, R7.1, U1.3 (INH), U1.7 (GND), U1.9 (EXPOSED_PAD), U2.3 (INH), U2.7 (GND), U2.9 (EXPOSED_PAD)
unnamed: C2.1, C4.1, U1.4 (COMP)
unnamed: C2.2, R1.1
unnamed: D1.C, L1.2, U1.1 (OUT)
unnamed: BATT.2, Q1.5 (D), Q1.6 (D), Q1.7 (D), Q1.8 (D)
unnamed: R2.1, R3.2, U1.5 (FB)
unnamed: D2.A, R4.1
unnamed: C6.1, C8.1, U2.4 (COMP)
unnamed: C6.2, R5.1
unnamed: D3.C, L2.2, U2.1 (OUT)
unnamed: R6.1, R7.2, U2.5 (FB)
unnamed: D4.A, R8.1
unnamed: BATT.1, PSW.2
V_BATT: C1.1, C5.1, JP1.4, PSW.1, Q1.4 (G), U1.8 (VCC), U2.8 (VCC)

Notes on the sheet:
Battery
To CPU
To MCU
+3.3V Regulator
+5V Regulator

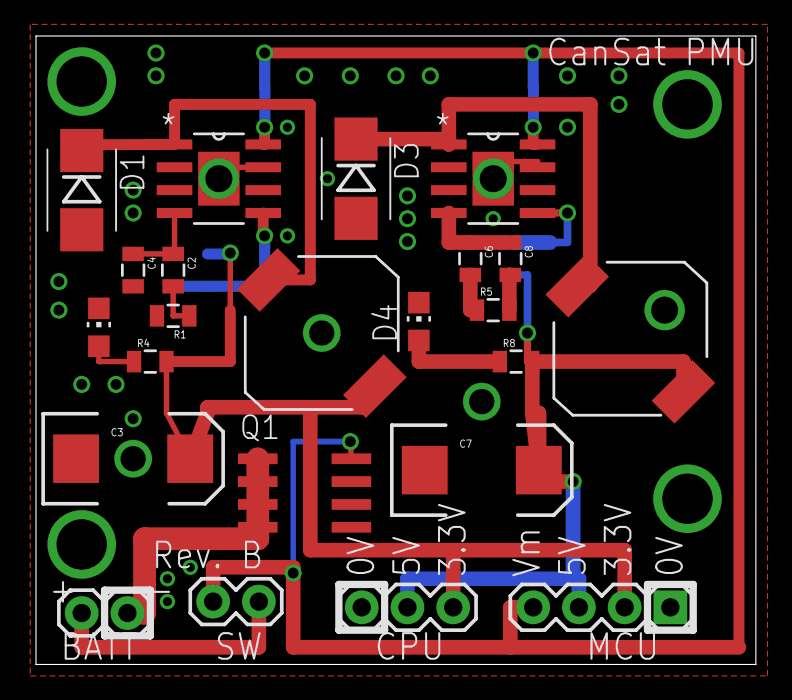
[picture p18: board pmu.brd from above]

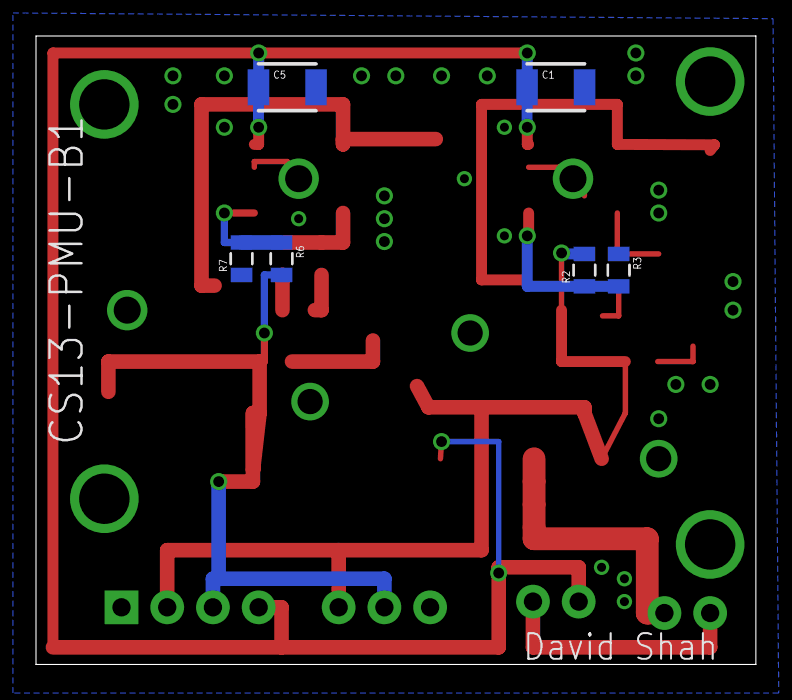
[picture p19: board pmu.brd from below]

Board: 2 copper layers, 40.0 x 34.9 mm, 29 parts (6 on the bottom side), 16 nets.
