daveshah1/nova/electronics/rover/mcu.brd

## EAGLE design electronics/rover/old (rev a)/mcu.brd (2013-09-23, an earlier design)

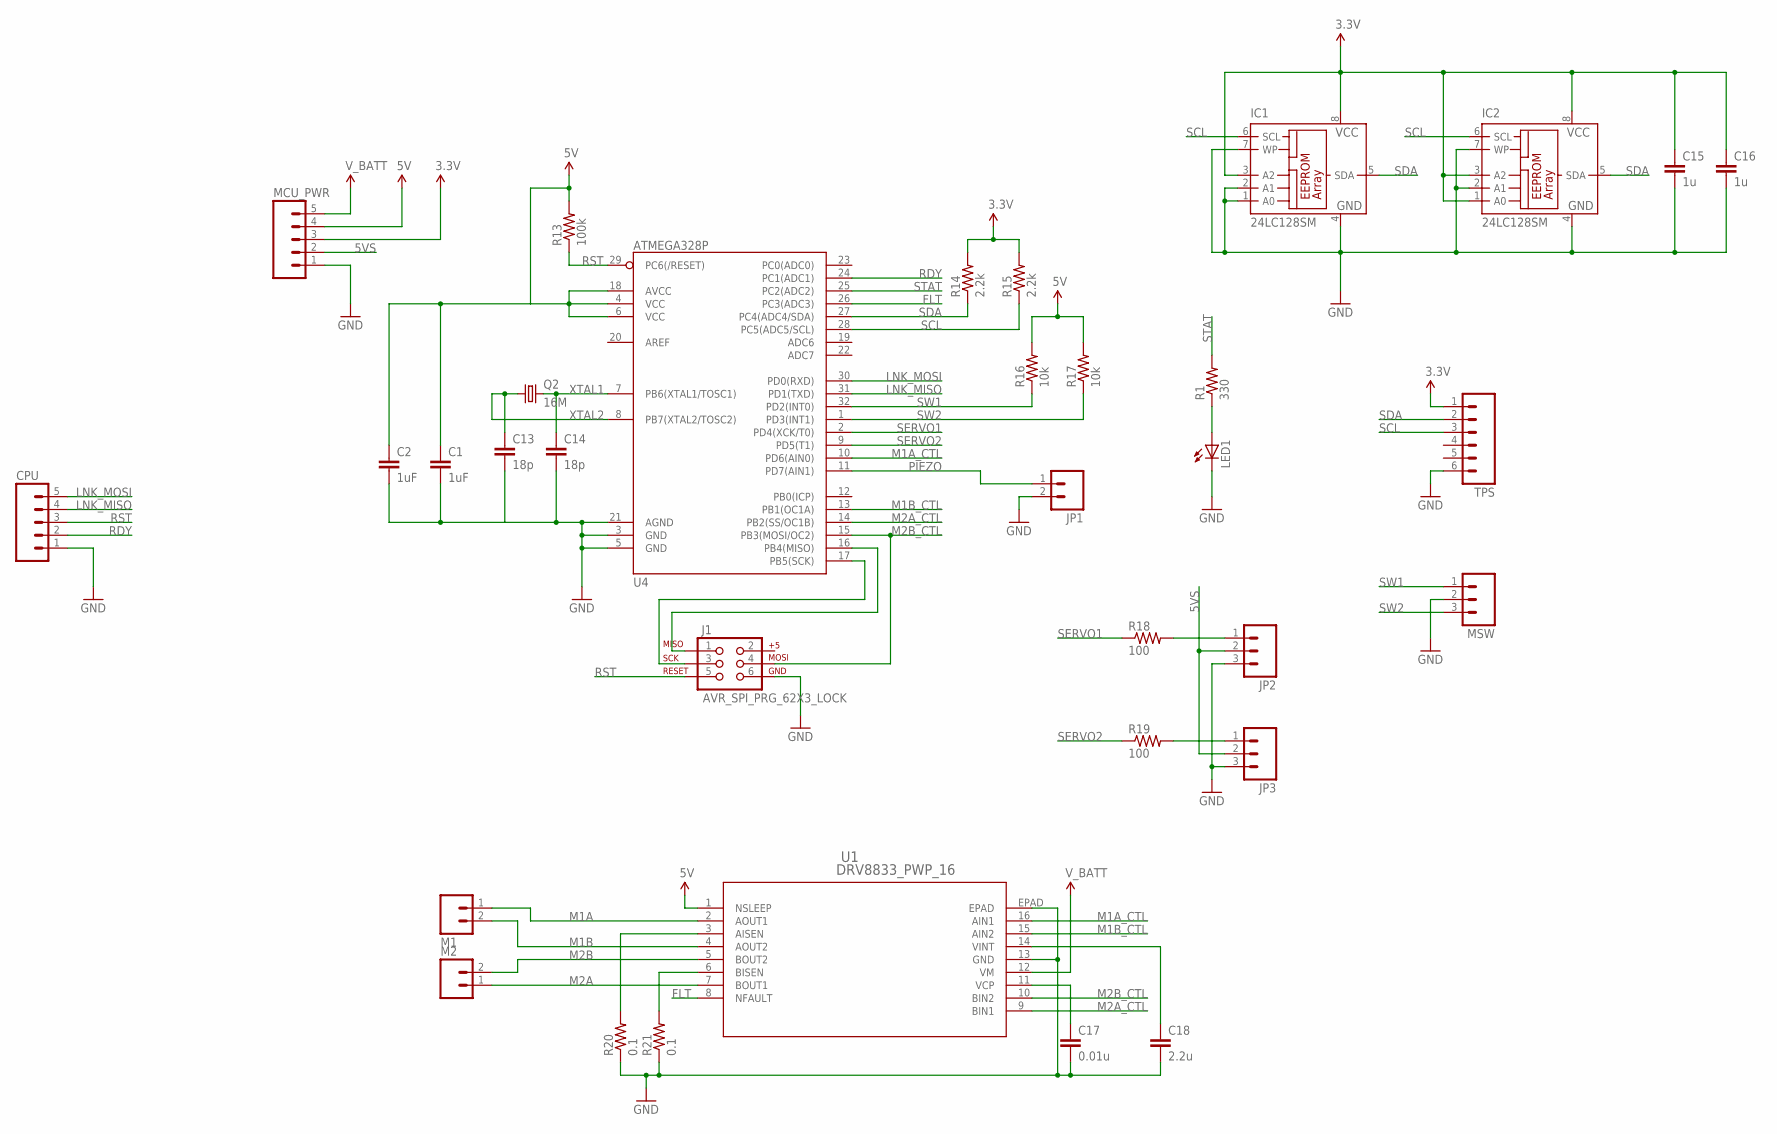
[picture p20: schematic mcu.sch]

Parts:
C1, C2: 1uF; 0805
C13, C14: 18p; 0805
C15, C16: 1u; 0805
C17: 0.01u; 0805
C18: 2.2u; 0805
CPU: M05PTH_LONGPADS; 1X05_LONGPADS
IC1, IC2: 24LC128SM; SO-08M
J1: AVR_SPI_PRG_62X3_LOCK; 2X3_LOCK
JP1: M02PTH3; 1X02_LONGPADS
JP2, JP3: M03LOCK_LONGPADS; 1X03_LOCK_LONGPADS
LED1: LED1206; LED-1206
M1, M2: M02PTH3; 1X02_LONGPADS
MCU_PWR: M05PTH; 1X05
MSW: M03LONGPADS; 1X03_LONGPADS
Q2: 16M; HC49UP
R1: 330; 0805
R13: 100k; 0805
R14, R15: 2.2k; 0805
R16, R17: 10k; 0805
R18, R19: 100; 0805
R20, R21: 0.1; 1206
TPS: M06LOCK; 1X06_LOCK
U1: DRV8833_PWP_16; PWP16_2P31X2P46
U4: ATMEGA328P; TQFP32-08

Connections:
3.3V: C15.1, C16.1, IC1.3 (A2), IC1.8 (VCC), IC2.1 (A0), IC2.3 (A2), IC2.8 (VCC), MCU_PWR.3, R14.2, R15.2, TPS.1
5V: C1.1, C2.1, MCU_PWR.4, R13.2, R16.2, R17.2, U1.1 (NSLEEP), U4.4 (VCC), U4.6 (VCC), U4.18 (AVCC)
5VS: JP2.2, JP3.2, MCU_PWR.2
FLT: U1.8 (NFAULT), U4.26 (PC3(ADC3))
GND: C1.2, C2.2, C13.2, C14.2, C15.2, C16.2, C17.2, C18.2, CPU.1, IC1.1 (A0), IC1.2 (A1), IC1.4 (GND), IC1.7 (WP), IC2.2 (A1), IC2.4 (GND), IC2.7 (WP), J1.6, JP1.2, JP2.3, JP3.3, LED1.C, MCU_PWR.1, MSW.2, R20.1, R21.1, TPS.6, U1.13 (GND), U1.EPAD, U4.3 (GND), U4.5 (GND), U4.21 (AGND)
LNK_MISO: CPU.4, U4.31 (PD1(TXD))
LNK_MOSI: CPU.5, U4.30 (PD0(RXD))
M1A: M1.1, U1.2 (AOUT1)
M1A_CTL: U1.16 (AIN1), U4.10 (PD6(AIN0))
M1B: M1.2, U1.4 (AOUT2)
M1B_CTL: U1.15 (AIN2), U4.13 (PB1(OC1A))
M2A: M2.1, U1.7 (BOUT1)
M2A_CTL: U1.9 (BIN1), U4.14 (PB2(SS/OC1B))
M2B: M2.2, U1.5 (BOUT2)
M2B_CTL: J1.4, U1.10 (BIN2), U4.15 (PB3(MOSI/OC2))
unnamed: LED1.A, R1.1
unnamed: JP2.1, R18.2
unnamed: J1.3, U4.17 (PB5(SCK))
unnamed: J1.1, U4.16 (PB4(MISO))
unnamed: JP3.1, R19.2
unnamed: C17.1, U1.11 (VCP)
unnamed: C18.1, U1.14 (VINT)
unnamed: R21.2, U1.6 (BISEN)
unnamed: R20.2, U1.3 (AISEN)
PIEZO: JP1.1, U4.11 (PD7(AIN1))
RDY: CPU.2, U4.24 (PC1(ADC1))
RST: CPU.3, J1.5, R13.1, U4.29 (PC6(/RESET))
SCL: IC1.6 (SCL), IC2.6 (SCL), R15.1, TPS.3, U4.28 (PC5(ADC5/SCL))
SDA: IC1.5 (SDA), IC2.5 (SDA), R14.1, TPS.2, U4.27 (PC4(ADC4/SDA))
SERVO1: R18.1, U4.2 (PD4(XCK/T0))
SERVO2: R19.1, U4.9 (PD5(T1))
STAT: R1.2, U4.25 (PC2(ADC2))
SW1: MSW.1, R16.1, U4.32 (PD2(INT0))
SW2: MSW.3, R17.1, U4.1 (PD3(INT1))
V_BATT: MCU_PWR.5, U1.12 (VM)
XTAL1: C14.1, Q2.2, U4.7 (PB6(XTAL1/TOSC1))
XTAL2: C13.1, Q2.1, U4.8 (PB7(XTAL2/TOSC2))

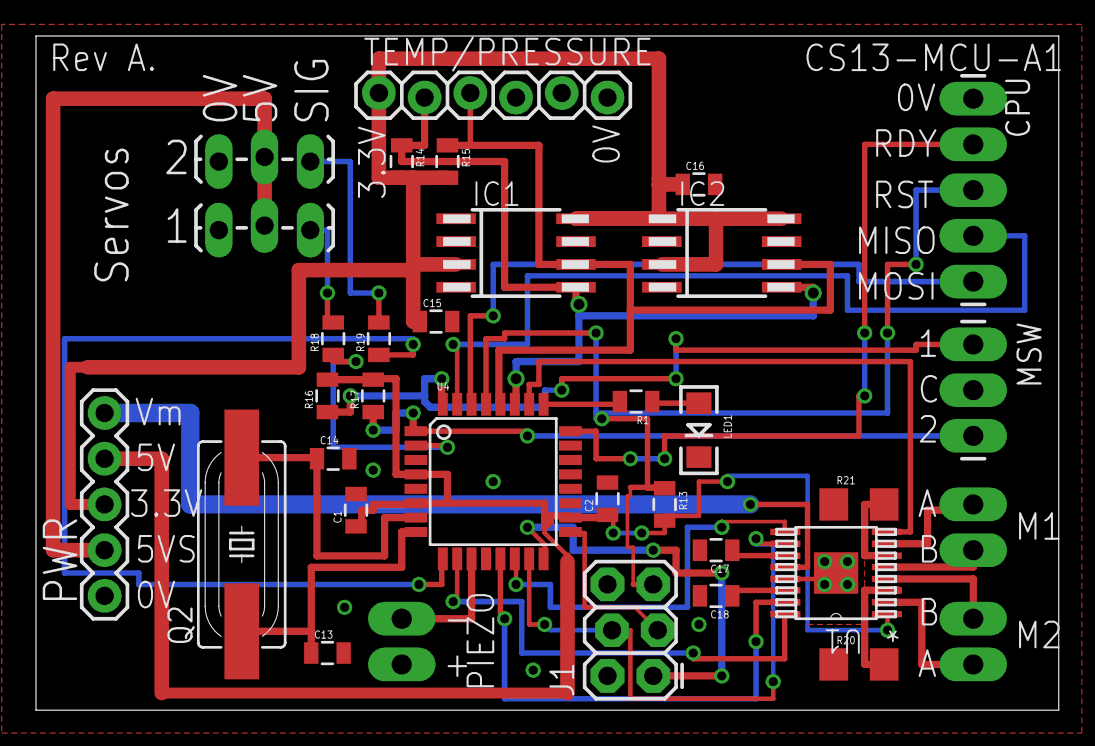
[picture p21: board mcu.brd from above]

Board: 2 copper layers, 56.8 x 37.5 mm, 34 parts (0 on the bottom side), 37 nets.
