daveshah1/nova/rover/gps.py

import serial
import time, os
import traceback
gpsPort = None
currentSentence = ""
debug = False
def begin():
    global gpsPort
    #Open serial port
    gpsPort = serial.Serial("/dev/ttyS1",9600,timeout=3)
    
def getSentence(code, timeout):
    global gpsPort, debug, currentSentence
    startTime = time.time()
    while((time.time() - startTime) < timeout):
        try:
            s = gpsPort.readline()
            if(len(s) > 10): 
                if(s[:6] == code): #Only interested in position updates for now
                    if(debug):
                        print "Got " + code + ": " + s
                    with open(os.environ['DIR'] + '/gps.log', 'a') as f:
                        f.write("Recieved Sentence: " + s + "\n")
                    return s
        except KeyboardInterrupt:
            exit(0)
        except:
            try: 
                #Log exception for failure analysis
                with open(os.environ['DIR'] + '/gps.log', 'a') as f:
                    f.write("+++++ EXCEPTION +++++\n")
                    f.write(traceback.format_exc() + "\n")
                if(debug):
                    print traceback.format_exc()
            except:
                pass #Just incase there is an exception in the exception handler...
            return ""
    return ""  

 
#begin()

def main():
    global debug
    debug = True
    begin()
    while(True):
        getSentence("$GPGGA",3)
if __name__ == "__main__":
    main()
