daveshah1/nova/arduino/baseStation/baseStation/lcd.h

prog_uchar PROGMEM pixel_data[120 * 41 * 3 + 1]  = "@<=745%!\";89\215\212\213#\37\40?;<URS\361\361\361\377\377\377\227\225\226"
  "\231\227\227\377\377\377\377\377\377\377\377\377\263\261\262\373\373\373"
  "\377\377\377\377\377\377\377\377\377\267\265\266\376\376\376\376\376\376"
  "\376\376\376\376\376\376\376\376\376\376\376\376\376\376\376\376\376\376"
  "\376\376\376\376\376\376\376\376\376\376\376\376\376\376\376\376\376\376"
  "\376\376\376\376\376\376\376\376\376\376\376\376\376\376\376\376\376\376"
  "\376\376\376\376\376\376\376\376\376\376\376\376\376\376\376\376\376\376"
  "\376\376\376\376\376\376\376\376\376\376\376\376\376\376\376\376\376\376"
  "\376\376\376\376\376\376\376\376\376\376\376\376\376\376\376\376\376\376"
  "\376\376\376\376\376\376\376\376\376\376\376\376\376\376\376\376\376\376"
  "\376\376\376\376\376\376\376\376\376\376\376\376\376\376\376\376\376\376"
  "\376\376\376\376\376\376\376\376\376\376\376\376\376\376\376\376\376\376"
  "\376\376\376\376\376\376\376\376\376\376\376\376\376\376\376\376\376\376"
  "\376\376\376\376\376\376\376\376\376\376\376\376\376\376\376\376\376\376"
  "\376\376\376\376\376\376\376\376\376\376\376\376\376\376\376\376\376\376"
  "\376\376\376\376\376\376\376\376\376\376\376\376\376\376\376\376\376\376"
  "\376\376\376\376\376\376\376\376\376\376\376\376\376\376\376\376\376\376"
  "\376\376\376\376\376\376\376\376\376\376\376\376\376\376\376\376\376\376"
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
  "\376\376\376\376\376\376\376\376\376\376\376\376\376\376\376\376\376\376"
  "\376\376\376\376\376\376*%&%!\"\376\376\376\376\376\376\376\376\376\376\376"
  "\376\376\376\376\376\376\376\376\376\376\376\376\376\326\325\325\327\326"
  "\326\327\326\326\326\326\326\376\376\376\376\376\376\376\376\376\376\376"
  "\376\376\376\376\376\376\376\376\376\376\376\376\376\376\376\376\376\376"
  "\376\376\376\376\376\376\376\376\376\376\376\376\376\376\376\376\376\376"
  "\376\376\376\376\376\376\376\376\376\376\376\376\376\376\376\376\327\326"
  "\326\327\326\326\327\326\326\326\326\326\331\331\331";
