daveshah1/nova/arduino/testing/Motor_Test/Motor_Test.ino

void setup() {
  pinMode(A2,OUTPUT);
  pinMode(A1,OUTPUT);
  
  pinMode(6,OUTPUT);
  pinMode(9,OUTPUT);
  pinMode(10,OUTPUT);
  pinMode(11,OUTPUT);
};

void loop() {
  digitalWrite(A2,HIGH);
  digitalWrite(6,HIGH);
  digitalWrite(9,LOW);
  digitalWrite(10,LOW);
  digitalWrite(11,HIGH);
  delay(400);
  digitalWrite(6,LOW);
  digitalWrite(9,LOW);
  digitalWrite(10,LOW);
  digitalWrite(11,LOW);  
  delay(100);
  digitalWrite(A2,LOW);
  digitalWrite(6,LOW);
  digitalWrite(9,HIGH);
  digitalWrite(10,HIGH);
  digitalWrite(11,LOW);
  delay(500);
   digitalWrite(6,LOW);
  digitalWrite(9,LOW);
  digitalWrite(10,LOW);
  digitalWrite(11,LOW);  
  delay(100);
};
