daveshah1/nova/arduino/testing/Landing_Module_Test/MPL3115A2.cpp

#include "MPL3115A2.h"
void MPL3115A2::begin() {
  setModeBarometer(); // Measure pressure in Pascals from 20 to 110 kPa
  setOversampleRate(7); // Set Oversample to the recommended 128
  enableEventFlags(); // Enable all three pressure and temp event flags
};

//Returns the number of meters above sea level
float MPL3115A2::readAltitude()
{
  toggleOneShot(); //Toggle the OST bit causing the sensor to immediately take another reading

  //Wait for PDR bit, indicates we have new pressure data
  int counter = 0;
  while( (IIC_Read(STATUS) & (1<<1)) == 0)
  {
      if(++counter > 100) return(-999); //Error out
      delay(1);
  }
  
  // Read pressure registers
  Wire.beginTransmission(MPL3115A2_ADDRESS);
  Wire.write(OUT_P_MSB); // Address of data to get
  Wire.endTransmission(false); // Send data to I2C dev with option for a repeated start. THIS IS NECESSARY and not supported before Arduino V1.0.1!
  Wire.requestFrom(MPL3115A2_ADDRESS, 3); // Request three bytes

  //Wait for data to become available
  counter = 0;
  while(Wire.available() < 3)
  {
    if(counter++ > 100) return(-999); //Error out
    delay(1);
  }

  byte msb, csb, lsb;
  msb = Wire.read();
  csb = Wire.read();
  lsb = Wire.read();

  toggleOneShot(); //Toggle the OST bit causing the sensor to immediately take another reading

  // The least significant bytes l_altitude and l_temp are 4-bit,
  // fractional values, so you must cast the calulation in (float),
  // shift the value over 4 spots to the right and divide by 16 (since
  // there are 16 values in 4-bits).
  float tempcsb = (lsb>>4)/16.0;

  float altitude = (float)( (msb << 8) | csb) + tempcsb;

  return(altitude);
}

//Reads the current pressure in Pa
//Unit must be set in barometric pressure mode
float MPL3115A2::readPressure()
{
  toggleOneShot(); //Toggle the OST bit causing the sensor to immediately take another reading

  //Wait for PDR bit, indicates we have new pressure data
  int counter = 0;
  while( (IIC_Read(STATUS) & (1<<2)) == 0)
  {
      if(++counter > 100) return(-999); //Error out
      delay(1);
  }

  // Read pressure registers
  Wire.beginTransmission(MPL3115A2_ADDRESS);
  Wire.write(OUT_P_MSB); // Address of data to get
  Wire.endTransmission(false); // Send data to I2C dev with option for a repeated start. THIS IS NECESSARY and not supported before Arduino V1.0.1!
  Wire.requestFrom(MPL3115A2_ADDRESS, 3); // Request three bytes

  //Wait for data to become available
  counter = 0;
  while(Wire.available() < 3)
  {
    if(counter++ > 100) return(-999); //Error out
    delay(1);
  }

  byte msb, csb, lsb;
  msb = Wire.read();
  csb = Wire.read();
  lsb = Wire.read();

  toggleOneShot(); //Toggle the OST bit causing the sensor to immediately take another reading

  // Pressure comes back as a left shifted 20 bit number
  long pressure_whole = (long)msb<<16 | (long)csb<<8 | (long)lsb;
  pressure_whole >>= 6; //Pressure is an 18 bit number with 2 bits of decimal. Get rid of decimal portion.

  lsb &= 0b00110000; //Bits 5/4 represent the fractional component
  lsb >>= 4; //Get it right aligned
  float pressure_decimal = (float)lsb/4.0; //Turn it into fraction

  float pressure = (float)pressure_whole + pressure_decimal;

  return(pressure);
}

bool MPL3115A2::isPresent() {
	if(IIC_Read(WHO_AM_I) == 196) return true;
	else return false;
};

float MPL3115A2::readTemp()
{
  toggleOneShot(); //Toggle the OST bit causing the sensor to immediately take another reading

  //Wait for TDR bit, indicates we have new temp data
  int counter = 0;
  while( (IIC_Read(STATUS) & (1<<1)) == 0)
  {
      if(++counter > 100) return(-999); //Error out
      delay(1);
  }
  
  // Read temperature registers
  Wire.beginTransmission(MPL3115A2_ADDRESS);
  Wire.write(OUT_T_MSB); // Address of data to get
  Wire.endTransmission(false); // Send data to I2C dev with option for a repeated start. THIS IS NECESSARY and not supported before Arduino V1.0.1!
  Wire.requestFrom(MPL3115A2_ADDRESS, 2); // Request two bytes

  //Wait for data to become available
  counter = 0;
  while(Wire.available() < 2)
  {
    if(++counter > 100) return(-999); //Error out
    delay(1);
  }

  byte msb, lsb;
  msb = Wire.read();
  lsb = Wire.read();
  
  // The least significant bytes l_altitude and l_temp are 4-bit,
  // fractional values, so you must cast the calulation in (float),
  // shift the value over 4 spots to the right and divide by 16 (since
  // there are 16 values in 4-bits).
  float templsb = (lsb>>4)/16.0; //temp, fraction of a degree

  float temperature = (float)(msb + templsb);

  return(temperature);
}

//Sets the mode to Barometer
//CTRL_REG1, ALT bit
void MPL3115A2::setModeBarometer()
{
  byte tempSetting = IIC_Read(CTRL_REG1); //Read current settings
  tempSetting &= ~(1<<7); //Clear ALT bit
  IIC_Write(CTRL_REG1, tempSetting);
}

//Sets the mode to Altimeter
//CTRL_REG1, ALT bit
void MPL3115A2::setModeAltimeter()
{
  byte tempSetting = IIC_Read(CTRL_REG1); //Read current settings
  tempSetting |= (1<<7); //Set ALT bit
  IIC_Write(CTRL_REG1, tempSetting);
}

//Puts the sensor in standby mode
//This is needed so that we can modify the major control registers
void MPL3115A2::setModeStandby()
{
  byte tempSetting = IIC_Read(CTRL_REG1); //Read current settings
  tempSetting &= ~(1<<0); //Clear SBYB bit for Standby mode
  IIC_Write(CTRL_REG1, tempSetting);
}

//Puts the sensor in active mode
//This is needed so that we can modify the major control registers
void MPL3115A2::setModeActive()
{
  byte tempSetting = IIC_Read(CTRL_REG1); //Read current settings
  tempSetting |= (1<<0); //Set SBYB bit for Active mode
  IIC_Write(CTRL_REG1, tempSetting);
}

//Setup FIFO mode to one of three modes. See page 26, table 31
//From user jr4284
void MPL3115A2::setFIFOMode(byte f_Mode)
{
  if (f_Mode > 3) f_Mode = 3; // FIFO value cannot exceed 3.
  f_Mode <<= 6; // Shift FIFO byte left 6 to put it in bits 6, 7.

  byte tempSetting = IIC_Read(F_SETUP); //Read current settings
  tempSetting &= ~(3<<6); // clear bits 6, 7
  tempSetting |= f_Mode; //Mask in new FIFO bits
  IIC_Write(F_SETUP, tempSetting);
}

//Call with a rate from 0 to 7. See page 33 for table of ratios.
//Sets the over sample rate. Datasheet calls for 128 but you can set it
//from 1 to 128 samples. The higher the oversample rate the greater
//the time between data samples.
void MPL3115A2::setOversampleRate(byte sampleRate)
{
  if(sampleRate > 7) sampleRate = 7; //OS cannot be larger than 0b.0111
  sampleRate <<= 3; //Align it for the CTRL_REG1 register

  byte tempSetting = IIC_Read(CTRL_REG1); //Read current settings
  tempSetting &= 0b11000111; //Clear out old OS bits
  tempSetting |= sampleRate; //Mask in new OS bits
  IIC_Write(CTRL_REG1, tempSetting);
}

//Clears then sets the OST bit which causes the sensor to immediately take another reading
//Needed to sample faster than 1Hz
void MPL3115A2::toggleOneShot(void)
{
  byte tempSetting = IIC_Read(CTRL_REG1); //Read current settings
  tempSetting &= ~(1<<1); //Clear OST bit
  IIC_Write(CTRL_REG1, tempSetting);

  tempSetting = IIC_Read(CTRL_REG1); //Read current settings to be safe
  tempSetting |= (1<<1); //Set OST bit
  IIC_Write(CTRL_REG1, tempSetting);
}

//Enables the pressure and temp measurement event flags so that we can
//test against them. This is recommended in datasheet during setup.
void MPL3115A2::enableEventFlags()
{
  IIC_Write(PT_DATA_CFG, 0x07); // Enable all three pressure and temp event flags
}

// These are the two I2C functions in this sketch.
byte MPL3115A2::IIC_Read(byte regAddr)
{
  // This function reads one byte over IIC
  Wire.beginTransmission(MPL3115A2_ADDRESS);
  Wire.write(regAddr); // Address of CTRL_REG1
  Wire.endTransmission(false); // Send data to I2C dev with option for a repeated start. THIS IS NECESSARY and not supported before Arduino V1.0.1!
  Wire.requestFrom(MPL3115A2_ADDRESS, 1); // Request the data...
  return Wire.read();
}

void MPL3115A2::IIC_Write(byte regAddr, byte value)
{
  // This function writes one byto over IIC
  Wire.beginTransmission(MPL3115A2_ADDRESS);
  Wire.write(regAddr);
  Wire.write(value);
  Wire.endTransmission(true);
}
