daveshah1/nova/arduino/testing/Landing_Module_Test/Landing_Module_Test.ino

#include <Wire.h>
#include "MPL3115A2.h"
MPL3115A2 tp;

//Software serial implementation
#include <ctype.h>

#define bit9600Delay 84  
#define halfBit9600Delay 42
#define bit4800Delay 188 
#define halfBit4800Delay 94 

byte rx = 6;
byte tx = 7;
byte SWval;


void SWprint(int data)
{
  byte mask;
  //startbit
  digitalWrite(tx,LOW);
  delayMicroseconds(bit9600Delay);
  for (mask = 0x01; mask>0; mask <<= 1) {
    if (data & mask){ // choose bit
     digitalWrite(tx,HIGH); // send 1
    }
    else{
     digitalWrite(tx,LOW); // send 0
    }
    delayMicroseconds(bit9600Delay);
  }
  //stop bit
  digitalWrite(tx, HIGH);
  delayMicroseconds(bit9600Delay);
}

int SWread()
{
  byte val = 0;
  while (digitalRead(rx));
  //wait for start bit
  if (digitalRead(rx) == LOW) {
    delayMicroseconds(halfBit9600Delay);
    for (int offset = 0; offset < 8; offset++) {
     delayMicroseconds(bit9600Delay);
     val |= digitalRead(rx) << offset;
    }
    //wait for stop bit + extra
    delayMicroseconds(bit9600Delay); 
    delayMicroseconds(bit9600Delay);
    return val;
  }
}

void setup() {
  pinMode(rx, INPUT);
  
  Serial.begin(57600);
  Serial.println("-- STARTING --");
  tp.begin();
  if(!tp.isPresent()) {
    Serial.println("MPL3115A2 not present or defective.");
  };
  
};
