daveshah1/nova/(commit log)

2013-09-23 Added Eagle schematics & PCBs
    [mcu.brd, mcu.sch, motherboard cp2.brd, motherboard cp2.sch, pmu.brd, pmu.sch]
2013-09-23 Added basic Arduino program
2013-09-24 More Arduino test code
2013-09-24 Added pressure/temperature test code
2013-09-24 Modified pressure/temperature code
2013-09-25 Revert "Meh"
    This reverts commit 564270c3b118b66e3fe7e008a8d5d9082352564a.
    [Main.java]
2013-09-26 Added arduino serial packet comms library
2013-09-27 Fixed getCommand, added getPayload
    [SerialPacket.cpp]
2013-09-27 Function prototypes for BMP085 library
    Based on code from http://sensorapp.net/?p=278
2013-09-27 Added BMP085 library
    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
2013-09-27 Added Arduino makefile
2013-09-28 More work on the Arduino code
2013-09-28 Added motor control to arduino code
2013-09-30 Added error checking to main.ino
    [main.ino]
2013-10-02 2nd experimental
    derpderpderp fix
    [Main.java]
2013-10-02 Tidied up Arduino code
2013-10-06 Added ant build files
    - Also several fixes & tweaks to the Java code.
    - Now ready for continuous integration
    [Main.java]
2013-10-09 Integrated Position class in main code
    Distances may not be very accurate (+/-10m) due to errors in the
    algorithm caused by the non-spherical nature of the Earth.
    [Main.java]
2013-10-10 Improved control buttons
    - Now correctly arranged
    - Also more correct naming (i.e. North/South instead of Up/Down)
    [Main.java]
2013-10-12 Improved control buttons, Improved spring layout
2013-11-29 Added new electronic designs
    [cpu.brd, cpu.sch, mcu.brd, mcu.sch, module.brd, module.sch, pmu.brd, pmu.sch]
2013-12-10 Changed SerialPacket to use static memory
    Should prevent any bugs occurring due to fragmentation following
    repeated allocation and deallocation of memory. Also means memory leaks
    should no longer be a threat.
    [SerialPacket.cpp, SerialPacket.h, main.ino]
2013-12-10 Added pins.h to Arduino code
2013-12-11 Updated Arduino code for new hardware
2013-12-29 Added more Arduino code
2014-01-01 Added readTP and motor control to arduino.py
2014-01-20 Added skeleton landing module code to client
2014-01-21 Landing module radio handling code
2014-01-22 Made CustomMap a LandingModuleListener
2014-01-24 Added NetworkImageViewer component
    Unfortunately true streaming video is too difficult on the gumstix side.
    This has been replaced by updating a picture every second or so and
    displaying this.
    Xuggler is now no longer a dependency.
    [Main.java]
2014-02-08 Fixed bugs in Arduino code
    [E2PROM.cpp, E2PROM.h, SerialPacket.cpp, rover.ino]
2014-02-13 ***WORKING TELEMETRY AND MOTOR CONTROL***
2014-02-20 Add wireless management script
2014-02-24 Enhancements and fixes to navcode
    [navigator.py]
2014-02-24 Added Landing Module Arduino Code
    Nearly finished. Partially tested.
2014-02-25 Landing module GPS code & FSM
2014-02-27 Fixes to base station serial code
    Includes C#-based sneaky workaround to serial communications
    [Main.java, baseStation.ino, landingModule.ino]
2014-02-28 SPI reliability improvements
2014-03-05 Add landingmodule display to LargeMap
